raphaelauv/quadcopter-raspberry-pi/src/Motor_drone/README

#compilation
gcc  -lwiringPi -lphread -c motors.c
gcc  -lwiringPi -lphread -o test motors.o test.c
