raphaelauv/quadcopter-raspberry-pi/Documentation/Documentation Drone Harware/Description des composant.odt

Description et utilisation des composants

Micro-moteurs :

Les micro-moteurs vont fournir la puissance nécessaire au drone pour décoller, en variant la vitesse de rotation de chaque moteurs il est possible de faire tanguer/tourner le drone autours d'un axe précis afin de contrôler sa trajectoire.

Avantage et inconvenant des moteurs à courant continue.

- Variation de vitesse, couple et sens de rotation simple a gérer

- Frottement des balais (perte de rendement, perte sous forme de chaleur,

usure a grande vitesse dut au frottement et au arcs électrique qui détériore

le commutateur)

Le problème causé par les balais est régler grâce au moteur sans balais (ou brushless en anglais) qui ne contient aucun balais tout en gardant les avantages des moteurs a courant continue.

A puissance égale ils ont un meilleur rendement et sont moins chère.

Comment choisir son moteur.

- Les kv :

Les kv sont le rapport tours/min par votl. Un trop grand kv rend la maniabilité difficile car des accélérations/décélérations trop importante au moindre changement de voltage.

- Les T :

Les T sont indique le couple. Plus le T est grand, plus le couple sera important.

Les kv et le couple sont fortement lié et inversement proportionnel.

- Les Watts :

Les Watts indique la consommation maximale du moteur.

- La poussé (Thrust) :

Pour pouvoir décoller facilement il faut que la poussé total des moteurs

soit le double de la charge total du drone (donc chaque moteur doit avoir une

poussé qui soit la moitié du poids du drone)

Variateur de vitesse :

Le variateur de vitesse contrôle la tension envoyer au moteurs afin de faire varié la vitesse de celui-ci. Il doit aussi laisser passer l’ampérage dont le moteur a besoin.

Il faut donc prévoir une marge d'ampérage pour ne pas que l'ESC (electronic speed control) ne chauffe lorsque le moteur tourne a plein régime.

Il se branche directement sur la batterie. Il possède une sortie triphasé, que l'on relie au moteur. En fonction du branchement des phases nous pouvons choisir le sens de rotation du moteur.

L'ESC possède aussi ce que l'on appel un BEC output, il sert a alimenter d'autres composants comme le récepteur radio ou le contrôleur. Il permet aussi de recevoir les

paramètres que lui envoie le contrôleur.

Capteurs :

L’accéléromètre

l'accéléromètre se sert du principe de l'inertie. Prenons un support a plat sur le quel on fixe une masse a l'aide d'un ressort (la masse et a la vertical par rapport au support)

Si le support subit une accélération verticale, vers le haut, l'inertie de la masse fera que celle-ci aura tendance a vouloir rester a sa position initial (dans l'espace) et exercera donc une force de compression sur le ressort (un peu comme quand l’ascenseur commence a monter et qu'on se sent un peu lourd).

Cette effort sur le ressort et mesuré par l'accéléromètre.

Il sert donc à mesurer une accélération linéaire sur un axe. On parle d’accéléromètre même lorsqu'il s’agit de 3 accéléromètre qui calcule les accélérations sur 3 axes orthogonaux.

Le gyroscope

Un gyroscope et un solide de révolution animé d'une grande vitesse de rotation, il a pour propriété fondamentale de s'opposer à toute force qui tendrait à modifier l'orientation de son axe de rotation (il conserve son axe de rotation dans l'espace absolue).

Le gyroscope est donc un capteur de position angulaire par rapport a un référentiel inertiel (ou galiléen). Il mesure donc l'angle du drone sur les 3 axes (les deux axes du plan qui sont appelé axes de roulis (barrel roll) et de tangage (looping) et l'axe vertical appelé axe de lacet)

Enfin les capteurs de pression, humidité et chaleur donne des information complémentaire, comme la hauteur (différence de pression) et les capteurs de chaleur et d'humidité peuvent repérer la présence proche d'un objet « vivant » (ou chaud et/ou humide)

La batterie (ou accumulateur)

Les batterie utilisé sont des Batterie LiPo, elle possède l'avantage de pouvoir fournir une tension « constante » lors de sont utilisation, ce qui n'etait pas le cas avec les les autre batterie qui perdait en puissance au cours de leur utilisation.

L’inconvénient et que si elle passe en dessous d'un seuil de tension, c'est tout simplement poubelle. Il ne faut pas passer en dessous des 2,8 ~ 3 V par élément, la tension de destruction étant à 2,5V

Il faut aussi faire attention a l'équilibre de tension entre chaque élément.

Si il y a un déséquilibre certaine cellule seront plus sollicité que d'autre ce qui détériore la batterie, idem à la charge.

Il faut donc penser a prendre un chargeur équilibreur et ce à chaque charge.

Il faut aussi penser a laisser les accumulateur se refroidir / se reposer entre chaque charge / décharge (entre 1/4h et 1h)

Sources

http://sparrowhawk-xxt.e-monsite.com/pages/technique/choisir-son-moteur-brushless-et-le-variateur.html

https://fr.wikipedia.org/wiki/Machine_%C3%A0_courant_continu

https://fr.wikipedia.org/wiki/Moteur_sans_balais

https://en.wikipedia.org/wiki/Battery_eliminator_circuit

https://fr.wikipedia.org/wiki/Acc%C3%A9l%C3%A9rom%C3%A8tre#Approche_intuitive (https://fr.wikipedia.org/wiki/Accéléromètre#Approche_intuitive)

https://fr.wikipedia.org/wiki/Gyroscope

http://blog.patrickmodelisme.com/post/qu-est-ce-qu-une-batterie-lipo
