raphaelauv/quadcopter-raspberry-pi/Documentation/ Documentation Code Softawre/Diagramme.jpeg

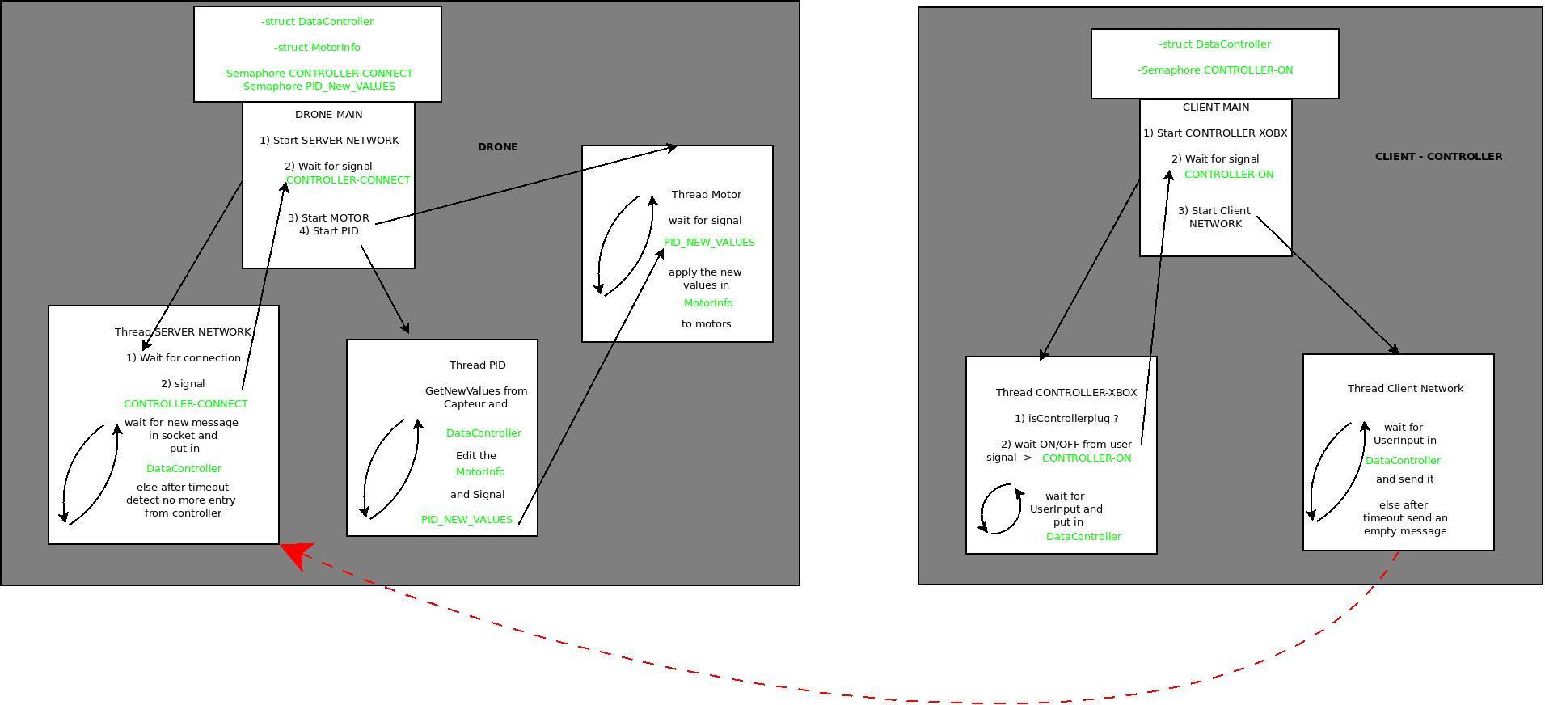
Documentation/ Documentation Code Softawre/Diagramme.jpeg
