raphaelauv/quadcopter-raspberry-pi/Documentation/ Documentation Code Softawre/Diagramme_client.png

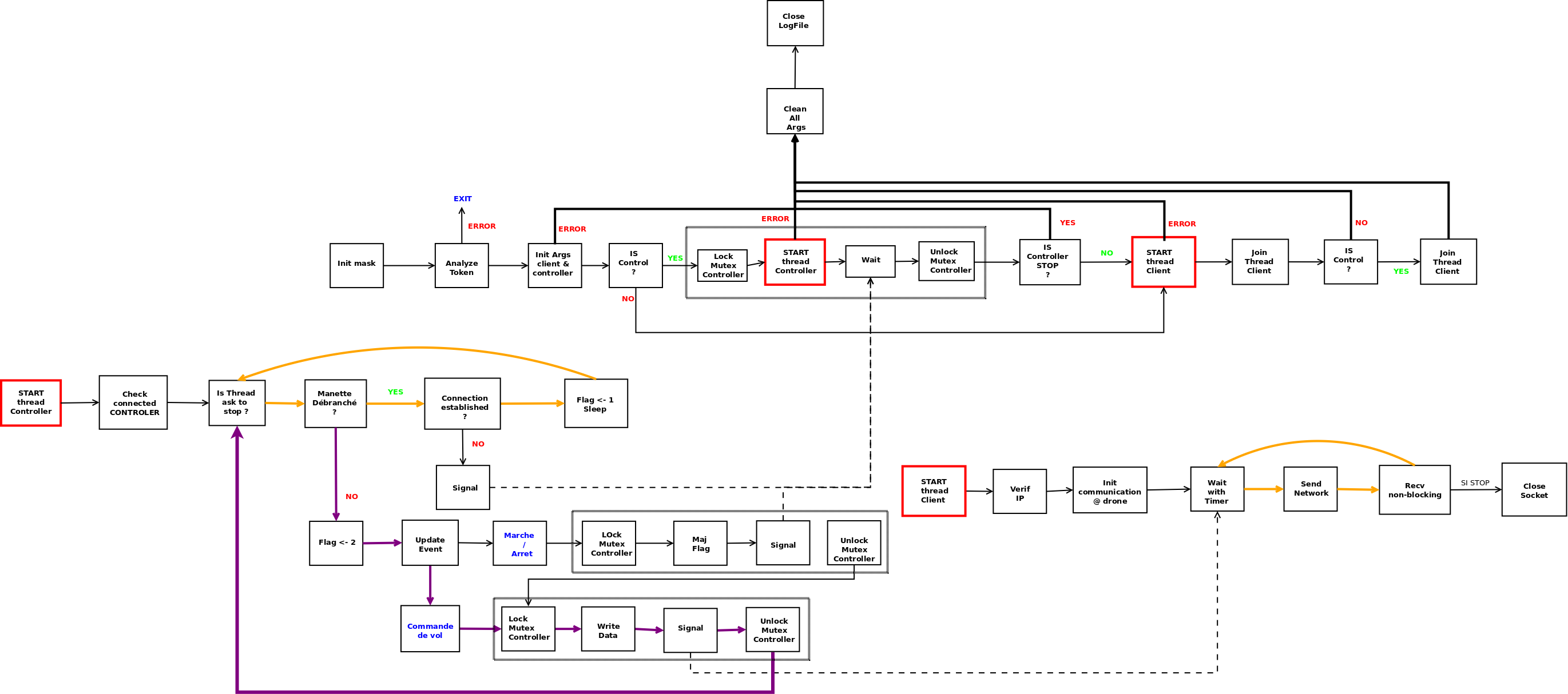
Documentation/ Documentation Code Softawre/Diagramme_client.png
