raphaelauv/quadcopter-raspberry-pi/Documentation/ Documentation Code Softawre/Diagramme_drone.png

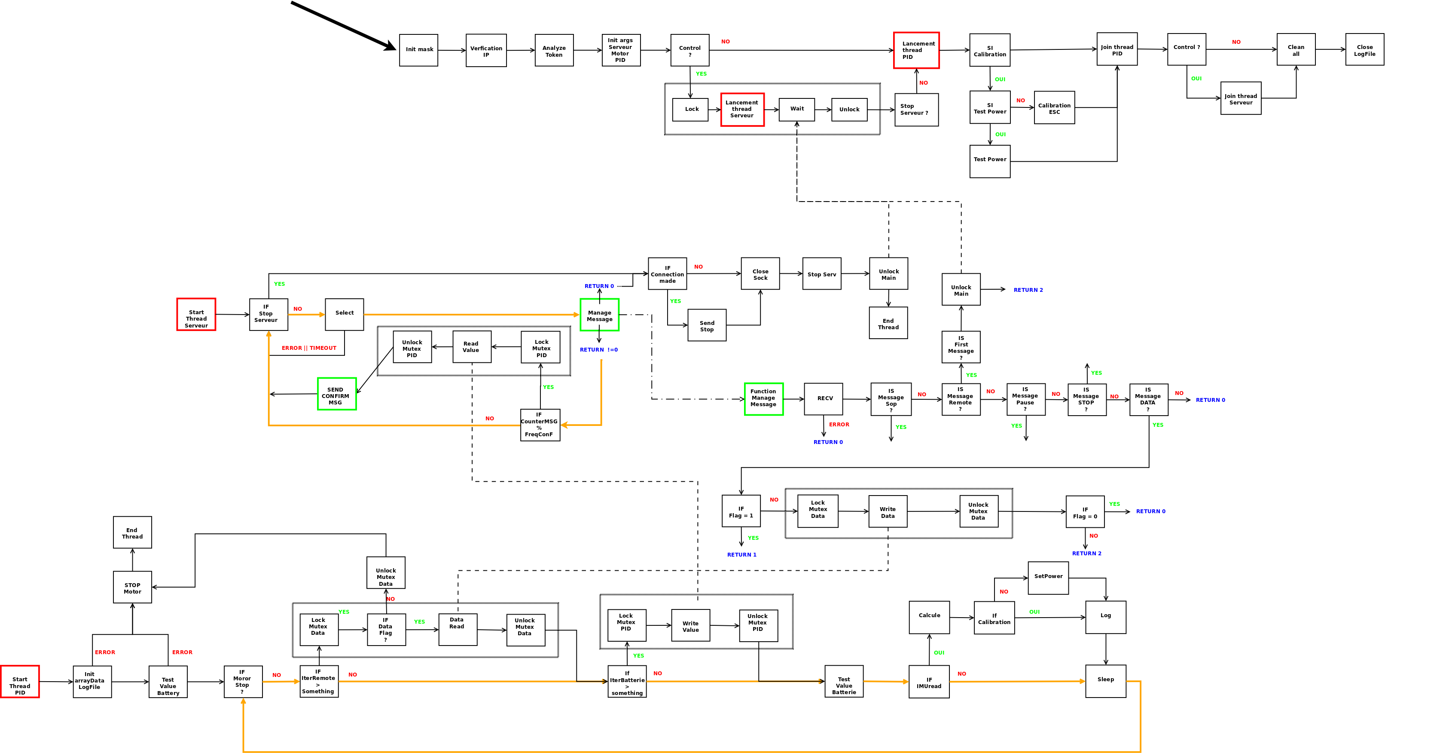
Documentation/ Documentation Code Softawre/Diagramme_drone.png
