raphaelauv/quadcopter-raspberry-pi/TODO.txt

#############################TODO#############################
-Fair un schema des branchement du drone(Andres)
-Monter le drone(ASAP).
-makefile avec library dynamique(Andres)
-Mode log avec graphe pour PID.
-mode log pour les motor(valeurs de la puissance des 4 motors).
-Gérer les signaux.(Adrian)
-Meme Test d’equilibrage  mais avec la manette.(Andres) 
-Test controlVol complet deja (ecrit) (Andres)
-Voir qu’elle materiel on aura besoin de plus? (Tous le monde).
-Filtre de Kalman (Barometre + accel) (Andres + ?)
-Test de securité.
-Comprendre le code de Raph. (Adrian + Andres).
