raphaelauv/quadcopter-raspberry-pi/plot/testPower droit dans la main.pdf

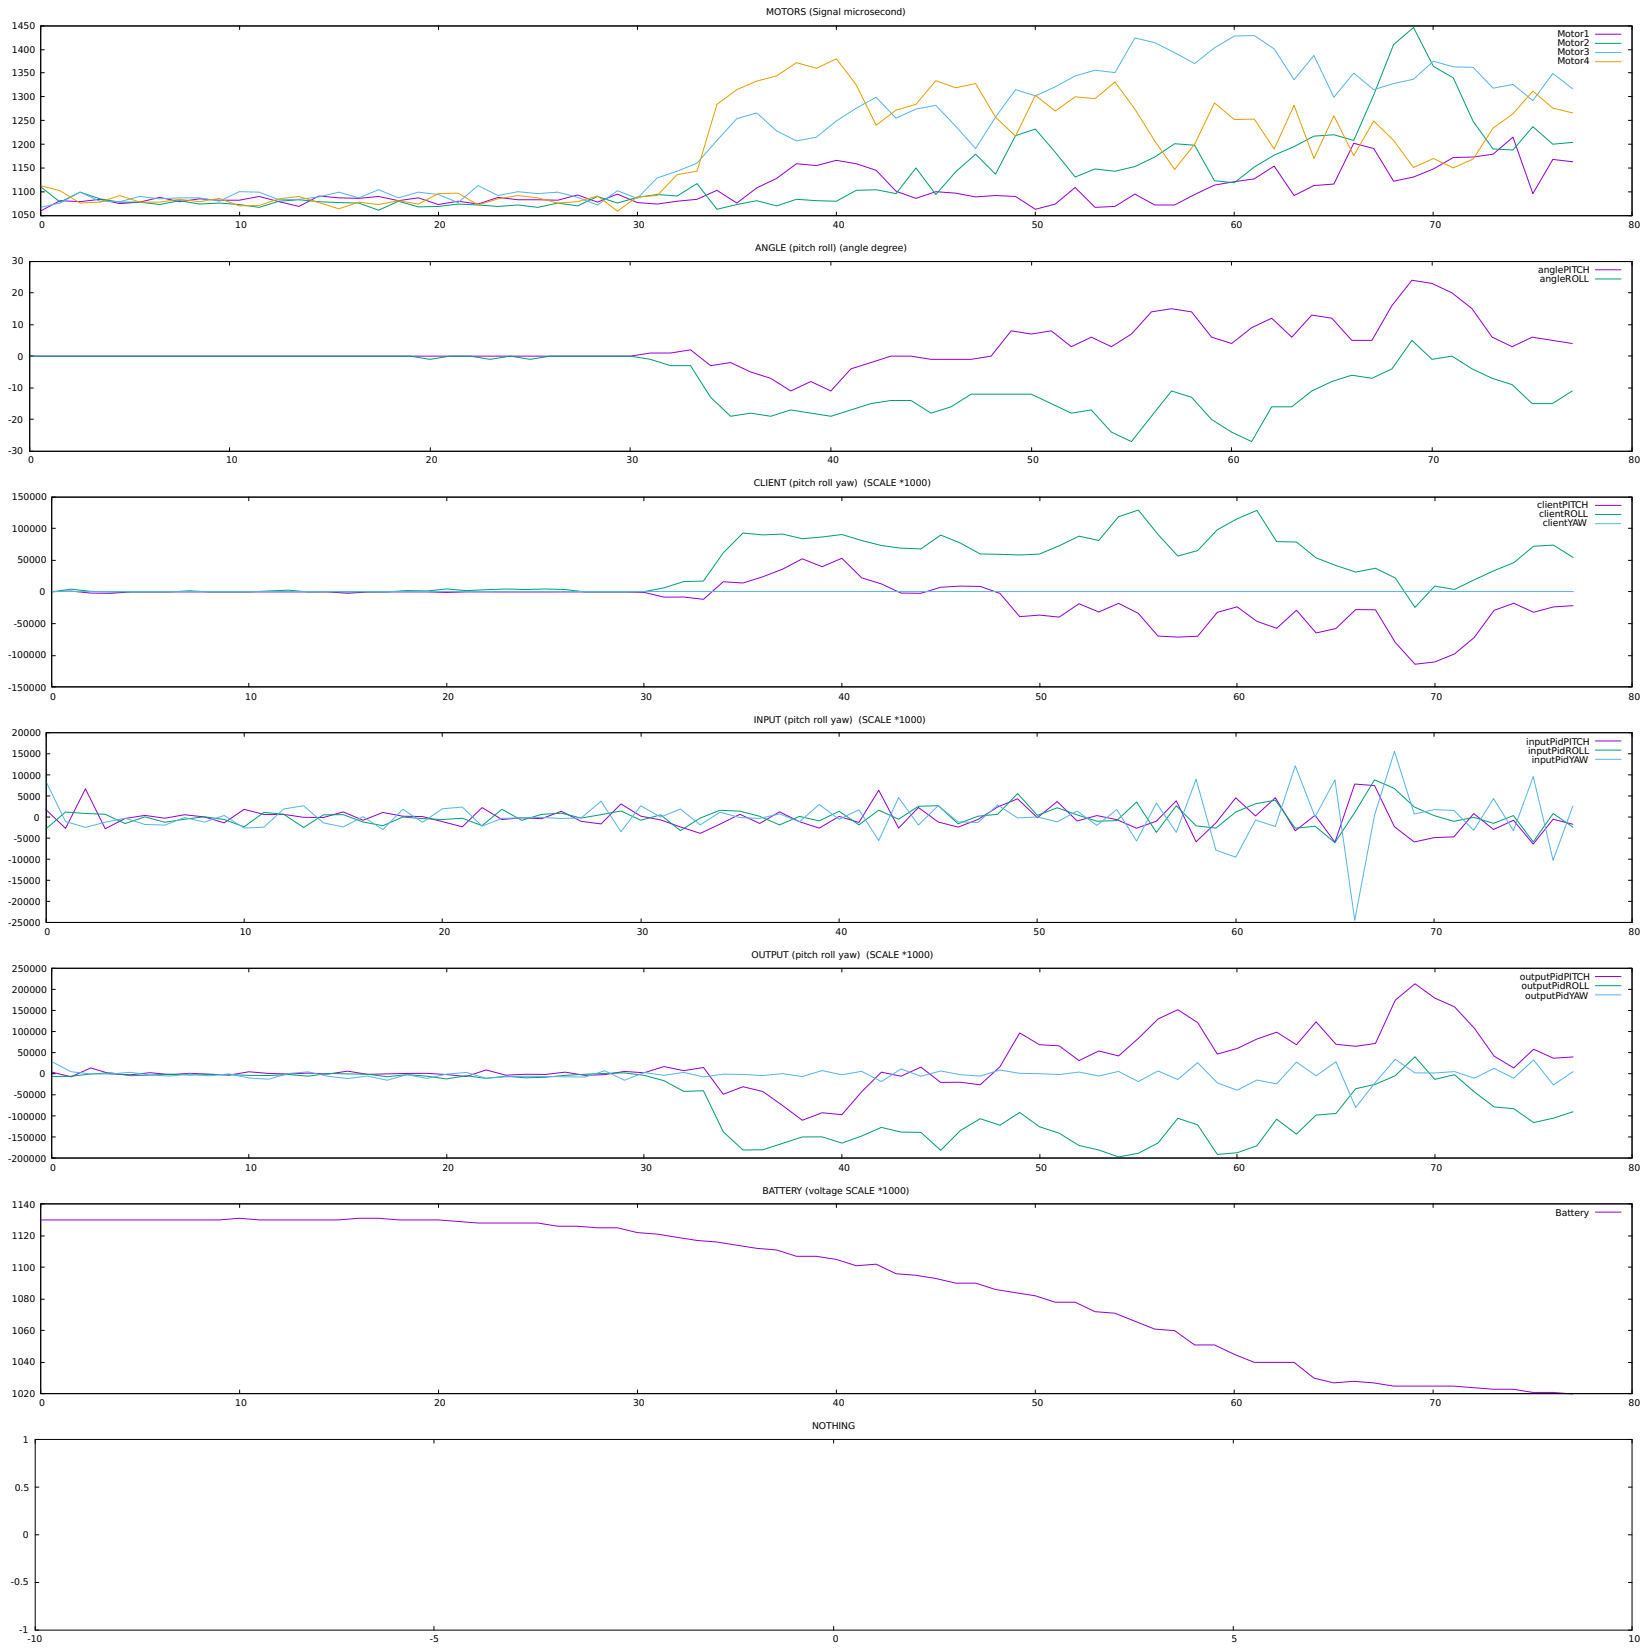
[picture p6: page 1]
Sig; al mic; pit; oll); gle; PITC; LIE; oll y; clie; YAW; 0 INPUT (pitch roll yaw) (SCALE *1000); inputPidPITCH inputPidROLL inputPidYAW; Pid; ATT; olt; HIN
