raphaelauv/quadcopter-raspberry-pi/Documentation/Documentation Drone Harware/Cablage_Drone.pdf

## Raspberry Pi 2

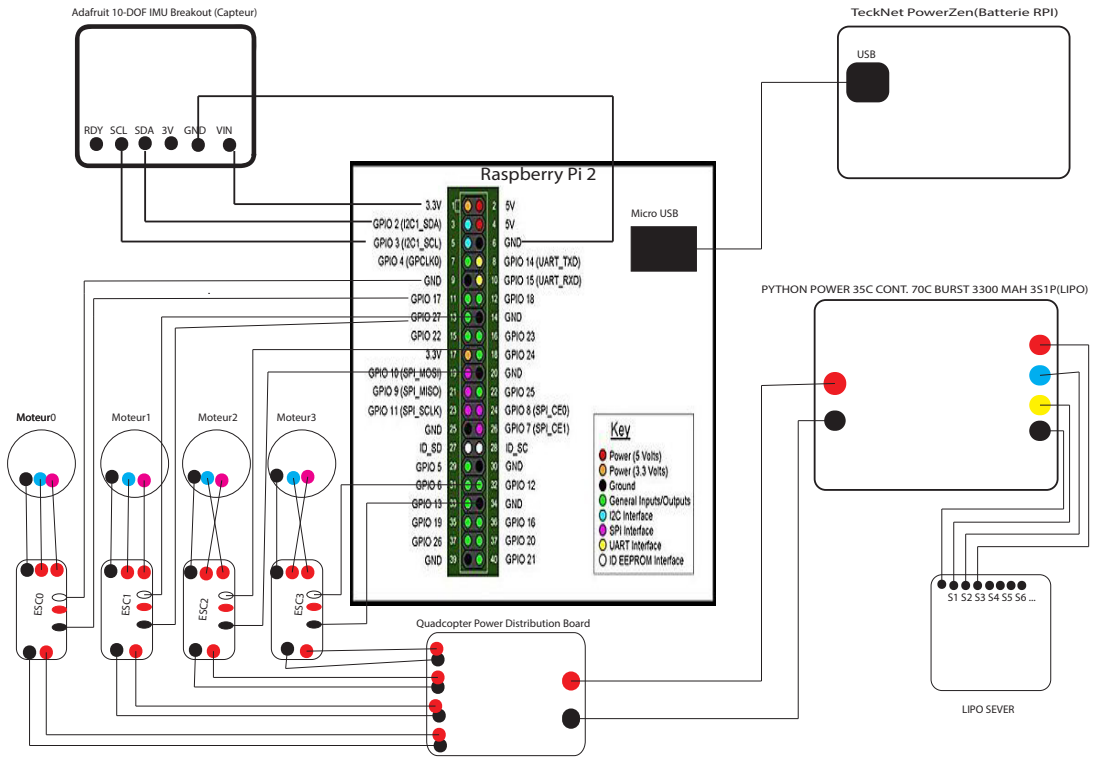
[picture p7: page 1]
Micro USB; USB; LIPO SEVER; ESC0; ESC1; ESC2; ESC3; Moteur0 Moteur; Moteur1; Moteur2; Moteur3

Adafruit 10-DOF IMU Breakout (Capteur)

TeckNet PowerZen(Batterie RPI)

RDY SCL SDA 3V GND VIN

PYTHON POWER 35C CONT. 70C BURST 3300 MAH 3S1P(LIPO)

Quadcopter Power Distribution Board
