raphaelauv/quadcopter-raspberry-pi/src/PID.cpp

#include "PID.hpp"


int init_args_PID(args_PID ** argPID){

#ifdef __arm__
	RTIMU *imu = NULL;
#endif

    *argPID =(args_PID *) malloc(sizeof(args_PID));
    if (*argPID == NULL) {
        logString("MALLOC FAIL : init_args_PID");
        return -1;
    }
    
    
#ifdef __arm__
    imu = sensorInit();
    if(imu==NULL){
        logString("ERROR NEW FAIL RTIMU ->imu");
        goto cleanFail;
    }else{
        logString("CAPTEUR INIT SUCCES");
        (*argPID)->imu=imu;
    }
#endif
    
    if(initHardwareADC(DEFAULT_CHANNEL_ADCNUM)){
    	logString("initHardwareADC FAIL");
    	goto cleanFail;
    }

    return 0;

cleanFail:
	clean_args_PID(*argPID);
	*argPID=NULL;
	return -1;
}

void clean_args_PID(args_PID * arg) {
    if (arg != NULL) {
		#ifdef __arm__
        if( arg->imu !=NULL){
            delete(arg->imu);
            arg->imu=NULL;
        }
		#endif
        free(arg);
    }
}




void * thread_PID(void * args);

/**
 * return 0 if Succes
 */
int start_thread_PID(pthread_t * threadPID,void *threadPID_stack_buf,args_PID * argPID){
    
    pthread_attr_t attributs;
    if(init_Attr_Pthread(&attributs,CPU_PRIORITY_PID,CPU_CORE_PID,threadPID_stack_buf)){
        logString("THREAD MAIN : ERROR pthread_attributs PID");
        return -1;
    }
    
    int result=pthread_create(threadPID, &attributs, thread_PID, argPID);
    if (result) {
        logString("THREAD MAIN : ERROR pthread_create PID");
        perror("pthread_create");
    }
    
    pthread_attr_destroy(&attributs);
    
    return result;
}



int absValue(int val){
    if(val<0){
        val*=-1;
    }
    val*=10;
    val+=1000;
    if(val<1000){
        val=1000;
    }
    else if(val>2000){
        val=2000;
    }
    return val;
}

float batteryValue=0;

int applyFiltreBatteryValue(){

	int batteryVoltage=hardwareReadADC(DEFAULT_CHANNEL_ADCNUM);
	if(batteryVoltage==-1){
		return -1;
	}

	//TODO PUT VALUES IN MACRO
	batteryValue=batteryValue* 0.92 + (batteryVoltage+60)* 0.09509;


	//batteryValue*=CONVERTION_TO_VOLT;

	return 0;

}

void * thread_PID(void * args){
	int continuThread=1;


	logString("THREAD PID : INITIALISATION");

    args_PID  * controle_vol =(args_PID  *)args;
    DataController * data = controle_vol->dataController;
    PMutex * mutexDataControler =controle_vol->dataController->pmutex;
    PID_INFO * pidInfo =controle_vol->pidInfo;

	#ifdef __arm__
    RTIMU *imu =(RTIMU *)controle_vol->imu;
	#endif

    long local_period=(1.0/FREQUENCY_PID) *SEC_TO_NSEC;

    
    int nbSENSOR_read_fail_InARow = 0;


    //Consigne client
    float client_gaz = MOTOR_MIN_ROTATE_TIME;
    float lastClient_gaz = client_gaz;
    char connectionlost = 0;

    int intervalReductionGAZ = 5;
    int nbConnectionLost_InARow = 0;

    int nbConnectionLost_GAZMIN = 0;

    float client_pitch = 0;
    float client_roll=0;
    float client_yaw=0;
    
    //input PID
    float input_pid_pitch;
    float input_pid_roll;
    float input_pid_yaw;
    //PID
    float output_pid_pitch = 0;
    float output_pid_roll = 0;
    float output_pid_yaw = 0;
    //erreur des PID
    float pid_erreur_tmp_pitch = 0;
    float pid_erreur_tmp_roll = 0;
    float pid_erreur_tmp_yaw = 0;
    //erreur accu
    float pid_accu_erreur_pitch = 0;
    float pid_accu_erreur_roll = 0;
    float pid_accu_erreur_yaw = 0;
    //last erreur
    float pid_last_pitch = 0;
    float pid_last_roll = 0;
    float pid_last_yaw = 0;
    
    // puissance des 4 moteur. (en microseconde)
    int puissance_motor0 = MOTOR_LOW_TIME;
    int puissance_motor1 = MOTOR_LOW_TIME;
    int puissance_motor2 = MOTOR_LOW_TIME;
    int puissance_motor3 = MOTOR_LOW_TIME;
    int powerTab[NUMBER_OF_MOTORS];
    int powerController[4];
    int powerMinRotate[NUMBER_OF_MOTORS];

    for(int i=0;i<NUMBER_OF_MOTORS;i++){
    	powerController[i]=0;
    	powerTab[i]=MOTOR_LOW_TIME;
    	powerMinRotate[i]=MOTOR_MIN_ROTATE_TIME;
    }

    
    RTIMU_DATA imuData;
    float gyro_cal[3]={0,0,0};

    
    int nb_values_log=NUMBER_OF_MOTORS+2+(3*3)+1;//( motors -> 4 ) + 2 angles ( (pitch roll yaw) * 3 ) + BatteryLevel
	int logTab[nb_values_log];
	int log_angle_pitch;
	int log_angle_roll;

	char arrayLog[SIZE_MAX_LOG];
	char arrayDATA[SIZE_MAX_LOG];

    struct timespec t0, t1 ,tim;
    int modeCalibration=isCalibration();

    int iterRemote=0;
    int iterBattery=0;
    int iterPrintPower=0;
    int iterBatteryPrint=0;
    int readSensorSucces=0;

	float gyro_x;
	float gyro_y;
	float gyro_z;

    /********VIBRATION******/
    float acc_total_vector[VIBRATION_Moving_average];
    for(int i=0;i<VIBRATION_Moving_average;i++){
    	acc_total_vector[i]=0;
    }
    float acc_av_vector;
    float vibration_total_result;
    float acc_x;
    float acc_y;
    float acc_z;

    int iterAccelPrint=0;
    int iterVibration;
    int testvibration=isTestVibration();
    float lastVibration;


    /*******SECURITY TIMER****/
    int iterSecurityTimer=0;
    int counterSecuTimer=PID_TIMER_TIME_SECURITE_SECONDE;
    int lastCounterSecuTimer=counterSecuTimer;
    int nanoSleepTimeIntervalOfSecurityTimer = NSEC_TO_SEC / PID_TIMER_VERIF_FREQUENCY;
    char tmpFlagRemoteMSG=0;
    int nbRotateSecuTimer=0;


    /*******DATA LOG FILE INIT****/
    char * strNameColumnDATA ="Motor1 Motor2 Motor3 Motor4 anglePITCH angleROLL clientPITCH clientROLL clientYAW inputPidPITCH inputPidROLL inputPidYAW outputPidPITCH outputPidROLL outputPidYAW Battery";
    if(setDataFrequence(50,nb_values_log)){
    	logString("THREAD PID : ERROR setDataFrequence");
    	goto endPid;
    }

    if (setDataStringTitle(strNameColumnDATA)) {
    	logString("THREAD PID : ERROR setDataStringTitle");
    	goto endPid;
	}





    /*********************************************************/
    /*				CALIBRATION ACCEL						*/
    /*
    int i;
	#ifdef __arm__
		for (i=0; i<2000; i++) {
			if(imu->IMURead()){
				imuData = imu->getIMUData();
				gyro_cal[0]+=imuData.gyro.x();
				gyro_cal[1]+=imuData.gyro.y();
				gyro_cal[2]+=imuData.gyro.z();
			}
			else{
				printf("trop rapide");
			}
			//usleep(2000);
			nanoSleepSecure(2000 *NSEC_TO_USEC_MULTIPLE);
		}
		gyro_cal[0]/=2000;
		gyro_cal[1]/=2000;
		gyro_cal[2]/=2000;
		printf("Calibration fini\n");
	#endif
    */



    /*********************************************************/
    /*				BATTERY INIT VALUE	+ TEST MOTO			*/

    for(int i=0;i<FREQUENCY_PID;i++){
    	if(applyFiltreBatteryValue()){
    		logString("THREAD PID : ERROR BATTERY VALUE");
    		goto endPid;
    	}

    	if(set_power(controle_vol->motorsAll, powerTab)){
    		goto endPid;
    	}
    }

    /*********************************************************/



    /*********************************************************/
    /*				START PID SECURITY TIMER				*/

    if(isCalibration()){
    	iterSecurityTimer=PID_TIMER_TIME_SECURITE_SECONDE * PID_TIMER_VERIF_FREQUENCY;
    	//to skip security timer
    }else{
    	logString("THREAD PID : SECURITY TIMER START");
    }


    while(iterSecurityTimer<PID_TIMER_TIME_SECURITE_SECONDE * PID_TIMER_VERIF_FREQUENCY){

    	iterSecurityTimer++;
    	pthread_mutex_lock(&(mutexDataControler->mutex));
    	tmpFlagRemoteMSG=data->flag;
    	pthread_mutex_unlock(&(mutexDataControler->mutex));
		if (tmpFlagRemoteMSG == 0) {
			continuThread=0;
			break;
		}
		if (is_Motor_Stop(controle_vol->motorsAll)) {
			continuThread=0;
			break;
		}

		if(iterSecurityTimer%PID_TIMER_VERIF_FREQUENCY==0){
			counterSecuTimer--;
			sprintf(arrayLog,"THREAD PID : SECURITY TIMER  %d",counterSecuTimer);
			logString(arrayLog);
		}

		if(lastCounterSecuTimer!=counterSecuTimer){
			lastCounterSecuTimer=counterSecuTimer;
			nbRotateSecuTimer=5;

		}

    	else{
    		clockNanoSleepSecure(nanoSleepTimeIntervalOfSecurityTimer);
		}

		//for very lite rotation of propeller during the timer security
		if(nbRotateSecuTimer>0){
			//set_power(controle_vol->motorsAll,powerMinRotate);
			nbRotateSecuTimer--;
		}else{
			//set_power(controle_vol->motorsAll,powerTab);
		}
    }
    /****************END SECURITY TIMER*************************/


    if(continuThread){
    	logString("THREAD PID : START");
    }

    while (continuThread) {

    	clock_gettime(CLOCK_MONOTONIC, &t0);//TODO

        if(is_Motor_Stop(controle_vol->motorsAll)){
        	break;
        }
        
        /*********************************************************/
        /*					CODE FOR GET REMOTE					*/
        iterRemote++;
        if(iterRemote>FREQUENCY_PID/FREQUENCY_CONTROLLER){
        	iterRemote=0;
            pthread_mutex_lock(&(mutexDataControler->mutex));
            if (data->flag== 0) {
                pthread_mutex_unlock(&(mutexDataControler->mutex));
                break;
                //TODO take a different decision when the flag is at 0 from the remote
            }else{
            	//mutexDataControler->var = 0;
				powerController[0] = data->axe_Rotation;
				powerController[1] = data->axe_UpDown;
				powerController[2] = data->axe_LeftRight;
				powerController[3] =(-1) * data->axe_FrontBack;
				pthread_mutex_unlock(&(mutexDataControler->mutex));


				/*
				Each motor id directly control by the pads of joystick
				powerTab[0] =absValue(powerController[0]);
				powerTab[1] =absValue(powerController[1]);
				powerTab[2] =absValue(powerController[2]);
				powerTab[3] =absValue(powerController[3]);
				printf("VALUES %d %d %d %d\n", powerTab[0],powerTab[1],powerTab[2],powerTab[3]);
				set_power(controle_vol->motorsAll,powerTab);
				*/

            }
            
        }

        /*********************************************************/
		/*					CODE BATTERY				*/
		iterBattery++;
		iterBatteryPrint++;
		if (iterBatteryPrint > (FREQUENCY_PID * 2)) {

			float voltageValue=batteryValue * 0.01;

			sprintf(arrayLog,"THREAD PID : Battery Value : %f",voltageValue);
			logString(arrayLog);
			iterBatteryPrint = 0;
		}


		if(applyFiltreBatteryValue()){
			logString("THREAD PID : ERROR BATTERY VALUE");
			//TODO
		}

        /************************END BATTERIE****************************/


		/************************POWER CLIENT****************************/
		pthread_mutex_lock(&(pidInfo->pmutex->mutex));
		connectionlost = pidInfo->connectionLost;
		pthread_mutex_unlock(&(pidInfo->pmutex->mutex));

		if (connectionlost) {

			nbConnectionLost_InARow++;
			if (nbConnectionLost_InARow % intervalReductionGAZ == 0) {
				client_gaz = lastClient_gaz--;
			}

			if (client_gaz <= 1300) {

				nbConnectionLost_GAZMIN++;

				if (nbConnectionLost_GAZMIN > FREQUENCY_PID * 11) {
					logString("THREAD PID : CONNECTION FAIL PID GO END");
					break;
				}else if (nbConnectionLost_GAZMIN > FREQUENCY_PID * 9) {
					client_gaz = 1050;
				}
				else if (nbConnectionLost_GAZMIN > FREQUENCY_PID * 7) {
					client_gaz = 1150;
				}
				else if (nbConnectionLost_GAZMIN > FREQUENCY_PID * 5) {
					client_gaz = 1250;
				}else{
					client_gaz = 1300;
				}

			}

		} else {
			nbConnectionLost_InARow = 0;
			if (powerController[1] >= 0) {

				//TODO add filter to limit burst du to reconnection

				client_gaz = (powerController[1]
						* (MAX_POURCENTAGE_POWER_USER / 10)) + MOTOR_LOW_TIME;
			}
		}

		if (client_gaz < MOTOR_MIN_ROTATE_TIME) {
			client_gaz = MOTOR_MIN_ROTATE_TIME;
		}

		lastClient_gaz = client_gaz;

		/***********************END POWER CLIENT**************************/
        
		#ifdef __arm__
        if(imu->IMURead()){
        	readSensorSucces=1;
        	nbSENSOR_read_fail_InARow=0;
        }else{
        	logString("THREAD PID : SENSOR FAIL READ");
        	readSensorSucces=0;
        	nbSENSOR_read_fail_InARow++;
        	if(nbSENSOR_read_fail_InARow>10){
        		//TODO
        	}
        }
		#endif

        if(readSensorSucces){
			#ifdef __arm__
            imuData = imu->getIMUData();
			#endif

            /*************************VIBRATION**********************/
            if(testvibration){

                acc_x=imuData.accel.x();
                acc_y=imuData.accel.y();
                acc_z=imuData.accel.z();
    			acc_total_vector[0] = sqrtf((acc_x * acc_x) + (acc_y * acc_y) + (acc_z * acc_z));

    			acc_av_vector = acc_total_vector[0];

    			for (int start = 16; start > 0; start--) {
    				acc_total_vector[start] = acc_total_vector[start - 1];
    				acc_av_vector += acc_total_vector[start];
    			}

    			acc_av_vector /= 17;

    			if (iterVibration < VIBRATION_Moving_average) {
    				iterVibration++;
    				vibration_total_result += fabsf(acc_total_vector[0] - acc_av_vector);
    			} else {
    				iterVibration = 0;
    				lastVibration = vibration_total_result/VIBRATION_Moving_average;
    				vibration_total_result = 0;
    			}
    			
    			iterAccelPrint++;
    			if (iterAccelPrint > (FREQUENCY_PID / 2)) {
    				iterAccelPrint = 0;
    				printf("ACCEL : X : %f  Y : %f  Z : %f | VECTEUR : %f | VIBRATION : %f \n", acc_x, acc_y, acc_z,acc_total_vector[0],lastVibration);
    			}
            }
            /**********************END VIBRATION**********************/


            /*************************PID*****************************/
            
            gyro_x=imuData.gyro.x();
            gyro_y=imuData.gyro.y();
            gyro_z=imuData.gyro.z();

			//printf("GYRO : X : %f  Y : %f  Z : %f \n",gyro_x, gyro_y, gyro_z);

            input_pid_pitch=(input_pid_pitch*0.7) + ((gyro_y-gyro_cal[0])*(180/M_PI)*0.3);
            input_pid_roll=(input_pid_roll*0.7) + ((gyro_x-gyro_cal[1])*(180/M_PI)*0.3);
            input_pid_yaw=(input_pid_yaw*0.7) + ((gyro_z-gyro_cal[2])*(180/M_PI)*0.3);
            
            //*power client

            client_pitch=powerController[3] * PID_ANGLE_PRECISION_MULTIPLE;
            client_roll=powerController[2] * PID_ANGLE_PRECISION_MULTIPLE;
            client_yaw=powerController[0] * PID_ANGLE_PRECISION_MULTIPLE;
            

            //TODO , correct the vibration first , before use the ANGLES
            /*
            log_angle_pitch=imuData.fusionPose.y() * RTMATH_RAD_TO_DEGREE;
            client_pitch-= log_angle_pitch * PID_ANGLE_MULTIPLE;
            */
            client_pitch/=3;

            /*
            log_angle_roll = imuData.fusionPose.x() * RTMATH_RAD_TO_DEGREE;
            client_roll-= log_angle_roll * PID_ANGLE_MULTIPLE;
            */
            client_roll/=3;
            
            client_yaw/=3;
            
            

            //calcule pitch PID
            pid_erreur_tmp_pitch=input_pid_pitch-client_pitch;
            pid_accu_erreur_pitch+=PID_GAIN_I_PITCH*pid_erreur_tmp_pitch;
            if (pid_accu_erreur_pitch>PID_MAX_PITCH) {
                pid_accu_erreur_pitch=PID_MAX_PITCH;
            }
            else if (pid_accu_erreur_pitch < -PID_MAX_PITCH){
                pid_accu_erreur_pitch=-PID_MAX_PITCH;
            }
            
            output_pid_pitch=PID_GAIN_P_PITCH*pid_erreur_tmp_pitch+pid_accu_erreur_pitch+PID_GAIN_D_PITCH*(pid_erreur_tmp_pitch-pid_last_pitch);
            
            if (output_pid_pitch>PID_MAX_PITCH) {
                output_pid_pitch=PID_MAX_PITCH;
            }
            else if (output_pid_pitch < -PID_MAX_PITCH){
                output_pid_pitch=-PID_MAX_PITCH;
            }
            pid_last_pitch=pid_erreur_tmp_pitch;
            //END PID PITCH
            
            //calcule roll PID
            pid_erreur_tmp_roll=input_pid_roll-client_roll;
            pid_accu_erreur_roll+=PID_GAIN_I_ROLL*pid_erreur_tmp_roll;
            if (pid_accu_erreur_roll>PID_MAX_ROLL) {
                pid_accu_erreur_roll=PID_MAX_ROLL;
            }
            else if (pid_accu_erreur_roll < -PID_MAX_ROLL){
                pid_accu_erreur_roll=-PID_MAX_ROLL;
            }
            
            output_pid_roll=PID_GAIN_P_ROLL*pid_erreur_tmp_roll+pid_accu_erreur_roll+PID_GAIN_D_ROLL*(pid_erreur_tmp_roll-pid_last_roll);

            if (output_pid_roll>PID_MAX_ROLL) {
                output_pid_roll=PID_MAX_ROLL;
            }
            else if (output_pid_roll < -PID_MAX_ROLL){
                output_pid_roll=-PID_MAX_ROLL;
            }
            
            pid_last_roll=pid_erreur_tmp_roll;
            //END PID ROLL
            
            //PID YAW
            pid_erreur_tmp_yaw=input_pid_yaw-client_yaw;
            pid_accu_erreur_yaw+=PID_GAIN_I_YAW*pid_erreur_tmp_yaw;
            
            if (pid_accu_erreur_yaw>PID_MAX_YAW) {
                pid_accu_erreur_yaw=PID_MAX_YAW;
            }
            else if (pid_accu_erreur_yaw < -PID_MAX_YAW){
                pid_accu_erreur_yaw=-PID_MAX_YAW;
            }
            
            output_pid_yaw=PID_GAIN_P_YAW*pid_erreur_tmp_yaw+pid_accu_erreur_yaw;
            
            if (output_pid_yaw>PID_MAX_YAW) {
                output_pid_yaw=PID_MAX_YAW;
            }
            else if (output_pid_yaw < -PID_MAX_YAW){
                output_pid_yaw=-PID_MAX_YAW;
            }
            
            
            
            puissance_motor0=client_gaz - output_pid_pitch + output_pid_roll - output_pid_yaw;
            puissance_motor1=client_gaz + output_pid_pitch + output_pid_roll + output_pid_yaw;
            puissance_motor2=client_gaz + output_pid_pitch - output_pid_roll - output_pid_yaw;
            puissance_motor3=client_gaz - output_pid_pitch - output_pid_roll + output_pid_yaw;

            /***********************END PID**********************/
        }


        /*******************BATTERY MOTOR CALIB**************/

		  //TODO
		 if(batteryValue<=BATTERY_HIGH_LIMIT && batteryValue>=BATTERY_LOW_LIMIT){
		/*
		 *
		 * NOT WORKING YET
			int a=10;
			int b=-20;
			puissance_motor0 +=  ((100 -   ((a*(batteryValue*0.01)) + b))  *puissance_motor0) / 100 ;
			puissance_motor1 +=  ((100 -   ((a*(batteryValue*0.01)) + b))  *puissance_motor1) / 100 ;
			puissance_motor2 +=  ((100 -   ((a*(batteryValue*0.01)) + b))  *puissance_motor2) / 100 ;
			puissance_motor3 +=  ((100 -   ((a*(batteryValue*0.01)) + b))  *puissance_motor3) / 100 ;
			*/

			/* WORKING , BUT NOT FULLY TEST
			puissance_motor0 += (1240 - batteryValue) /3500 * puissance_motor0 ;
			puissance_motor1 += (1240 - batteryValue) /3500 * puissance_motor1 ;
			puissance_motor2 += (1240 - batteryValue) /3500 * puissance_motor2 ;
			puissance_motor3 += (1240 - batteryValue) /3500 * puissance_motor3 ;

			*/

		  }
		  /*****************END BATTERY MOTOR CALIB*************/


		  /*******************SECURITY VALUES MOTORS**************/

		  //NEVER STOP ROTATION OF PROPELLERS
		  if(puissance_motor0<MOTOR_MIN_ROTATE_TIME) puissance_motor0=MOTOR_MIN_ROTATE_TIME;
		  if(puissance_motor1<MOTOR_MIN_ROTATE_TIME) puissance_motor1=MOTOR_MIN_ROTATE_TIME;
		  if(puissance_motor2<MOTOR_MIN_ROTATE_TIME) puissance_motor2=MOTOR_MIN_ROTATE_TIME;
		  if(puissance_motor3<MOTOR_MIN_ROTATE_TIME) puissance_motor3=MOTOR_MIN_ROTATE_TIME;

		  //MAXIMUM TO ASK IS LIMIT OF MOTORS
		  if(puissance_motor0>MOTOR_HIGH_TIME) puissance_motor0=MOTOR_HIGH_TIME;
		  if(puissance_motor1>MOTOR_HIGH_TIME) puissance_motor1=MOTOR_HIGH_TIME;
		  if(puissance_motor2>MOTOR_HIGH_TIME) puissance_motor2=MOTOR_HIGH_TIME;
		  if(puissance_motor3>MOTOR_HIGH_TIME) puissance_motor3=MOTOR_HIGH_TIME;

		  /****************END SECURITY VALUES MOTORS************/
	/*
		  iterPrintPower++;
		  if (iterPrintPower > (FREQUENCY_PID * 5)) {
			iterPrintPower=0;
			printf("PUISSANCE : %d %d %d %d \n", puissance_motor0,puissance_motor1,puissance_motor2,puissance_motor3);
		}

	*/

		powerTab[0] = puissance_motor0;
		powerTab[1] = puissance_motor1;
		powerTab[2] = puissance_motor2;
		powerTab[3] = puissance_motor3;

		if (modeCalibration) {
			//nothing to apply because we are in a calibrate mode execution
		} else {
			set_power(controle_vol->motorsAll, powerTab);
			//TODO test return value of set_power and take a decision !!
		}

		/*************************END PID****************************/


		/****************************LOG*****************************/
		logTab[0]=powerTab[0];
		logTab[1]=powerTab[1];
		logTab[2]=powerTab[2];
		logTab[3]=powerTab[3];

		logTab[4]=(int)log_angle_pitch;
		logTab[5]=(int)log_angle_roll;

		logTab[6]=(int) (client_pitch * LOG_FLOAT_MULTIPLIER);
		logTab[7]=(int) (client_roll * LOG_FLOAT_MULTIPLIER);
		logTab[8]=(int) (client_yaw  * LOG_FLOAT_MULTIPLIER);

		logTab[9]=(int) (input_pid_pitch  * LOG_FLOAT_MULTIPLIER);
		logTab[10]=(int) (input_pid_roll * LOG_FLOAT_MULTIPLIER);
		logTab[11]=(int) (input_pid_yaw * LOG_FLOAT_MULTIPLIER);

		logTab[12]=(int) (output_pid_pitch * LOG_FLOAT_MULTIPLIER);
		logTab[13]=(int) (output_pid_roll * LOG_FLOAT_MULTIPLIER);
		logTab[14]=(int) (output_pid_yaw * LOG_FLOAT_MULTIPLIER);

		logTab[15]=(int) batteryValue;
		logDataFreq(logTab,nb_values_log,arrayDATA);

		pthread_mutex_lock(&(pidInfo->pmutex->mutex));

		for(int i=0;i<SIZE_MAX_LOG;i++){
			pidInfo->logData[i]=arrayDATA[i];
		}
		pthread_mutex_unlock(&(pidInfo->pmutex->mutex));

		/**************************END LOG***************************/

        
        /***********SLEEP PID FREQUENCY****************/

        clock_gettime(CLOCK_MONOTONIC, &t1);//TODO
        long timeBetween=t1.tv_nsec - t0.tv_nsec;
        time_t timeSec= t1.tv_sec - t0.tv_sec;
        if(timeSec>0){
        	timeSec *=SEC_TO_NSEC;
        	timeBetween+=timeSec;
        }

		tim.tv_sec = 0;
		tim.tv_nsec = local_period - timeBetween ;
		if(timeBetween<0){

		}
		else if(timeBetween>=local_period){
			sprintf(arrayLog,"THREAD PID : TIME : %ld\n",local_period-timeBetween);
			logString(arrayLog);
		}else{

			clockNanoSleepSecure(tim.tv_nsec);
		}
		/***********END SLEEP PID FREQUENCY***********/

    }


endPid:

    set_Motor_Stop(controle_vol->motorsAll);
    logString("THREAD PID : END");
    return NULL;
}
