raphaelauv/quadcopter-raspberry-pi/src/RTIMULibDrive.cpp

////////////////////////////////////////////////////////////////////////////
//
//  This file is part of RTIMULib
//
//  Copyright (c) 2014-2015, richards-tech, LLC
//
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

#include "RTIMULib/RTIMULib.h"

int main()
{
    int sampleCount = 0;
    int sampleRate = 0;
    uint64_t rateTimer;
    uint64_t displayTimer;
    uint64_t now;

    //  Using RTIMULib here allows it to use the .ini file generated by RTIMULibDemo.
    //  Or, you can create the .ini in some other directory by using:
    //      RTIMUSettings *settings = new RTIMUSettings("<directory path>", "RTIMULib");
    //  where <directory path> is the path to where the .ini file is to be loaded/saved

    RTIMUSettings *settings = new RTIMUSettings("RTIMULib");

    printf("Avant appel\n");

    RTIMU *imu = RTIMU::createIMU(settings);

    printf("%s",imu->IMUName());

    if ((imu == NULL) || (imu->IMUType() == RTIMU_TYPE_NULL)) {
        printf("No IMU found\n");
        exit(1);
    }

    printf("ICI\n");

    //  This is an opportunity to manually override any settings before the call IMUInit

    //  set up IMU

    imu->IMUInit();

    printf("apres IMUInit\n");

    //  this is a convenient place to change fusion parameters

    imu->setSlerpPower(0.02);
    imu->setGyroEnable(true);
    imu->setAccelEnable(true);
    imu->setCompassEnable(true);

    //  set up for rate timer

    rateTimer = displayTimer = RTMath::currentUSecsSinceEpoch();

    //  now just process data

    while (1) {
        //  poll at the rate recommended by the IMU

        usleep(imu->IMUGetPollInterval() * 1000);

        while (imu->IMURead()) {
            RTIMU_DATA imuData = imu->getIMUData();
            sampleCount++;

            now = RTMath::currentUSecsSinceEpoch();

            //  display 10 times per second

            if ((now - displayTimer) > 100000) {
                printf("Sample rate %d: %s\r", sampleRate, RTMath::displayDegrees("", imuData.fusionPose));
                fflush(stdout);
                displayTimer = now;
            }

            //  update rate every second

            if ((now - rateTimer) > 1000000) {
                sampleRate = sampleCount;
                sampleCount = 0;
                rateTimer = now;
            }
        }
    }
}
