raphaelauv/quadcopter-raspberry-pi/src/serv.c

#include "serv.h"

void set_Serv_Stop(args_SERVER * argServ){
	pthread_mutex_lock(&argServ->pmutexServ->mutex);
	argServ->servStop=1;
	pthread_mutex_unlock(&argServ->pmutexServ->mutex);
}
int is_Serv_Stop(args_SERVER * argServ){

	//first look to glabal signal value
	int value=*(argServ->signalServStop);
	if(value){
		set_Serv_Stop(argServ);
		return value;

	//or look to the atomic value
	}else{
		pthread_mutex_lock(&argServ->pmutexServ->mutex);
		value=argServ->servStop;
		pthread_mutex_unlock(&argServ->pmutexServ->mutex);
		return value;
	}
}

int init_args_SERVER(args_SERVER ** argServ,volatile sig_atomic_t * signalServStop){

	PMutex * PmutexPID_INFO = NULL;
	PMutex * PmutexDataControler = NULL;
	PMutex * PmutexRemoteConnect = NULL;
	PMutex * PmutexServ = NULL;

	PID_INFO * pidInfo = NULL;
	DataController * dataControl = NULL;

	struct sockaddr_in adr_svr;
	memset(&adr_svr, 0, sizeof(adr_svr));
	adr_svr.sin_family 		= AF_INET;
	adr_svr.sin_addr.s_addr = htonl(INADDR_ANY);
	adr_svr.sin_port 		= htons(UDP_PORT_DRONE);



	*argServ = (args_SERVER *) malloc(sizeof(args_SERVER));
	if (*argServ == NULL) {
		logString("MALLOC FAIL : argServ");
		goto cleanFail;
	}


	if (((*argServ)->sock = socket(PF_INET, SOCK_DGRAM, 0)) == -1) {
		logString("SOCKET FAIL : open Socket error");
		goto cleanFail;
	}


	if(bindUDPSock(&((*argServ)->sock),&adr_svr) == -1){
		goto cleanFail;
	}



	/****************************PID_INFO**********************************/

	pidInfo = (PID_INFO *) malloc(sizeof(PID_INFO));
	if (pidInfo == NULL) {
		logString("MALLOC FAIL : pidInfo");
		goto cleanFail;
	}
	(*argServ)->pidInfo=pidInfo;

	(*argServ)->pidInfo->connectionLost = 0;

	PmutexPID_INFO = (PMutex *) malloc(sizeof(PMutex));
	if (PmutexPID_INFO == NULL) {
		logString("MALLOC FAIL : PmutexPID_INFO");
		goto cleanFail;
	}
	init_PMutex(PmutexPID_INFO);
	pidInfo->pmutex=PmutexPID_INFO;

	/**********************************************************************/


	/**************************DATA CONTROLLER*****************************/

	dataControl = (DataController *) malloc(sizeof(DataController));
	if (dataControl == NULL) {
		logString("MALLOC FAIL : dataControl");
		goto cleanFail;
	}
	(*argServ)->dataController = dataControl;


	PmutexDataControler = (PMutex *) malloc(sizeof(PMutex));
	if (PmutexDataControler == NULL) {
		logString("MALLOC FAIL : PmutexDataControler");
		goto cleanFail;
	}
	dataControl->pmutex=PmutexDataControler;
	init_PMutex(PmutexDataControler);
	dataControl->flag=2;

	/**********************************************************************/



	PmutexRemoteConnect = (PMutex *) malloc(sizeof(PMutex));
	if (PmutexRemoteConnect == NULL) {
		logString("MALLOC FAIL : PmutexRemoteConnect");
		goto cleanFail;
	}
	(*argServ)->pmutexRemoteConnect = PmutexRemoteConnect;
	init_PMutex(PmutexRemoteConnect);

	(*argServ)->signalServStop=signalServStop;
	(*argServ)->servStop=0;


	PmutexServ = (PMutex *) malloc(sizeof(PMutex));
	if (PmutexServ == NULL) {
		logString("MALLOC FAIL : mutexServ");
		goto cleanFail;
	}
	(*argServ)->pmutexServ=PmutexServ;
	init_PMutex(PmutexServ);


	return 0;

cleanFail:
	clean_args_SERVER(*argServ);
	*argServ=NULL;
	return -1;

}


void clean_args_SERVER(args_SERVER * arg) {
	if (arg != NULL) {
		clean_PMutex(arg->pmutexRemoteConnect);
		clean_PMutex(arg->pmutexServ);
		clean_DataController(arg->dataController);
		clean_PID_INFO(arg->pidInfo);
		free(arg);
	}
}

void MessageToStruc(char * message,int sizeFloat,DataController * dataTmp){

	//TODO write a real and good code for this
	int tmp=SIZE_MSG_HEADER_DATA;

	float a=strtof(message+tmp,NULL);

	tmp+=sizeFloat-1;

	float b=strtof(message+tmp-1,NULL);

	tmp+=sizeFloat-1;

	float c=strtof(message+tmp-1,NULL);

	tmp+=sizeFloat-1;

	float d=strtof(message+tmp-1,NULL);

	tmp+=sizeFloat-1;

	float flagTMP=strtof(message+tmp-1,NULL);

	char flag = (char ) flagTMP;

	dataTmp->axe_Rotation=a;
	dataTmp->axe_UpDown=b;
	dataTmp->axe_LeftRight=c;
	dataTmp->axe_FrontBack=d;
	dataTmp->flag=flag;

}


void unlockWaitMain(args_SERVER *argSERV) {
	pthread_mutex_lock(&argSERV->pmutexRemoteConnect->mutex);
	pthread_cond_signal(&argSERV->pmutexRemoteConnect->condition);
	pthread_mutex_unlock(&argSERV->pmutexRemoteConnect->mutex);
}


int firstMessage=1;
struct sockaddr_in adr_send;
int runServ = 1;
int socketConnectionMade=0;

/**
 * Manage the new Message receve by the drone
 *
 * return the flag value inside the message or -1 in case of wrong message
 */
int manageNewMessage(args_SERVER *argSERV,int sock,char * buff,int * cmpNumberMessage,DataController * dataTmp){

	if (receveNetwork(sock, NULL, buff)) {
		//TODO prendre decision sur controleur de vol , demander atterissage
		logString("THREAD SERV : RECEVE NETWORK ERROR");
		return 0;
	}


	buff[SIZE_SOCKET_MESSAGE-1] = '\0';

	char array[SIZE_MAX_LOG];
	sprintf(array, "THREAD SERV : msg receve : %s", buff);
	//logString(array);

	(*cmpNumberMessage)++;

	if(isMessageStop(buff)){

	}
	else if(isMessageRemote(buff)){

		sprintf(array, "THREAD SERV : mesg receve : %s", buff);
		logString(array);
		memset(&adr_send, 0, sizeof(adr_send));
		adr_send.sin_family = AF_INET;

		if (get_IP_Port(buff, &adr_send) != 1) {
			logString("ERROR IP RECEVE");
		} else {
			logString("THREAD SERV : GOOD IP AND PORT RECEVE");
			socketConnectionMade = 1;
			if (firstMessage) {
				unlockWaitMain(argSERV);
				firstMessage = 0;
			}
			return 2;
		}



	}else if(isMessagePause(buff)){

	}else if(isMessageStop(buff)){

	}else if(isMessageData(buff)){
		MessageToStruc(buff, 10, dataTmp);

		if(dataTmp->flag==1){
			logString("THREAD SERV : PAUSE MESSAGE");
			return 1;
		}

		else {

			/*
			if(argSERV->verbose){
				printf ("THREAD SERV : float a = %.6f  |float b = %.6f  |float c = %.6f  |float d = %.6f  | FLAG = %d\n",
						dataTmp->axe_Rotation ,dataTmp->axe_UpDown,dataTmp->axe_LeftRight,dataTmp->axe_FrontBack,dataTmp->flag);
			}
			*/


			pthread_mutex_lock(&argSERV->dataController->pmutex->mutex);

			argSERV->dataController->axe_Rotation=dataTmp->axe_Rotation;
			argSERV->dataController->axe_UpDown=dataTmp->axe_UpDown;
			argSERV->dataController->axe_LeftRight=dataTmp->axe_LeftRight;
			argSERV->dataController->axe_FrontBack=dataTmp->axe_FrontBack;
			argSERV->dataController->flag=dataTmp->flag;
			//argSERV->dataController->pmutex->var=1;

			//pthread_cond_signal(&(argSERV->dataController->pmutex->condition));

			pthread_mutex_unlock(&(argSERV->dataController->pmutex->mutex));

			if (dataTmp->flag == 0) {
				logString("THREAD SERV : FLAG 0 MESSAGE");
				return 0;
			}
			return 2;
		}

	}


	else{
		logString("THREAD SERV : UNKNOW MESSAGE\n");
		return -1;
	}
}

void *thread_UDP_SERVER(void *args) {

	args_SERVER *argSERV = (args_SERVER*) args;


	PID_INFO * pidInfo =argSERV->pidInfo;

	logString("THREAD SERV : SERVEUR UDP");
	int sock=argSERV->sock;

	int cmpNumberMessage = 1;
	char buff[SIZE_SOCKET_MESSAGE];

	/*********************************************************************/
	/*				SELECT ON UDP SOCKET*/
	/*********************************************************************/

	DataController dataTmp;

	fcntl(sock, F_SETFL, O_NONBLOCK);
	int fd_max = sock + 1;
	struct timeval tv;
	fd_set rdfs;

	int counterMsg=0;
	int freqConfirm=(int)FREQUENCY_CONTROLLER;

	
	int nbTimeOutInARow=0;
	while(runServ){

		if(is_Serv_Stop(argSERV)){
			break;
		}

		FD_ZERO(&rdfs);
		FD_SET(sock, &rdfs);
		tv.tv_sec = UDP_TIME_SEC_TIMER;
		tv.tv_usec = UDP_TIME_USEC_TIMER;
		int ret = select(fd_max, &rdfs, NULL, NULL, &tv);
		if (ret == 0) {

			if (socketConnectionMade) {

				if(nbTimeOutInARow>10){

					pthread_mutex_lock(&(pidInfo->pmutex->mutex));
					pidInfo->connectionLost = 1;
					pthread_mutex_unlock(&(pidInfo->pmutex->mutex));

					pthread_mutex_lock(&argSERV->dataController->pmutex->mutex);
					argSERV->dataController->axe_Rotation=0;
					argSERV->dataController->axe_UpDown=0;
					argSERV->dataController->axe_LeftRight=0;
					argSERV->dataController->axe_FrontBack=0;
					pthread_mutex_unlock(&(argSERV->dataController->pmutex->mutex));

					logString("THREAD SERV : Timed out");
				}else{
					nbTimeOutInARow++;
				}
			}


		} else if (FD_ISSET(sock, &rdfs)) {

			if(nbTimeOutInARow>10){
				pthread_mutex_lock(&(pidInfo->pmutex->mutex));
				pidInfo->connectionLost = 0;
				pthread_mutex_unlock(&(pidInfo->pmutex->mutex));
			}
			nbTimeOutInARow=0;
			counterMsg++;
			if(counterMsg%freqConfirm==0){

				float voltageValue;

				pthread_mutex_lock(&(pidInfo->pmutex->mutex));
				//voltageValue=pidInfo->battery;

				char arrayDATA[SIZE_MAX_LOG];
				for (int i = 0; i < SIZE_MAX_LOG; i++) {
					arrayDATA[i]=pidInfo->logData[i];
				}

				pthread_mutex_unlock(&(pidInfo->pmutex->mutex));

				char confirm[SIZE_SOCKET_MESSAGE];
				sprintf(confirm, "CONFIRM | DATA : %s", arrayDATA);

				if (sendNetwork(sock, &adr_send, confirm) == -1) {
					logString("THREAD SERV : NETWORK ERROR DURING -> SEND CONFIRM");
					//TODO
				}
			}

			if(manageNewMessage(argSERV,sock,buff,&cmpNumberMessage,&dataTmp)==0){
				//flag 0 receve
				runServ=0;
			}

		} else {
			logString("THREAD SERV : SELECT WITHOUT GOOD VALUE");
		}
	}

	/*********************************************************************/
	/*				CLOSE CONNECTION AND THREAD							 */
	/*********************************************************************/


	if (socketConnectionMade) {
		/*
		 * Code without any receve security ( and no need for )
		 * NO CRITIC SECTION
		 */
		char stop[SIZE_MSG_HEADER_STOP+1] = STR_STOP;
		logString("THREAD SERV : SEND STOP");
		for (int i = 0; i < 10; i++) {
			if (sendNetwork(sock, &adr_send, stop) == -1) {
				logString("THREAD SERV : NETWORK ERROR DURING -> SEND STOP");
				break;
			}
		}

	}

	close(sock);

	set_Serv_Stop(argSERV);
	//unlock Main
	unlockWaitMain(argSERV);

	logString("THREAD SERV : END");

	return NULL;
}
