raphaelauv/quadcopter-raspberry-pi/src/client.c

#include "client.h"


void dataControllerToMessage(int sizeFloat,char * output,DataController * dataController);
void concat(const char *typeMsg,const char *s1, const char *s2, char * messageWithInfo);


int init_args_CLIENT(args_CLIENT ** argClient,char * adresse,args_CONTROLLER * argController,volatile sig_atomic_t * signalClientStop){

	struct sockaddr_in * adr_client = NULL;
	PMutex * mutex = NULL;
	int sock=-1;

	* argClient =(args_CLIENT *) malloc(sizeof(args_CLIENT));
	if (*argClient == NULL) {
		logString("MALLOC FAIL : argClient");
		return -1;
	}

	(*argClient)->adresse=adresse;//TODO do a copy
	(*argClient)->argController=argController;
	(*argClient)->signalClientStop=signalClientStop;
	(*argClient)->clientStop=0;


	mutex =	(PMutex *) malloc(sizeof(PMutex));
	if (mutex == NULL) {
		logString("MALLOC FAIL : init_args_CLIENT mutex");
		goto cleanFail;
	}
	(*argClient)->pmutexClient=mutex;
	init_PMutex(mutex);


	if ((sock = socket(PF_INET, SOCK_DGRAM, 0)) == -1) {
		logString("args_CLIENT CLIENT : Socket error");
		goto cleanFail;
	}
	(*argClient)->sock=sock;

	//adr_my is for reception from drone
	struct sockaddr_in adr_my;
	memset(&adr_my, 0, sizeof(adr_my));
	adr_my.sin_family 		= AF_INET;
	adr_my.sin_addr.s_addr 	= htonl(INADDR_ANY);
	adr_my.sin_port 		= htons(UDP_PORT_REMOTE);


	if(bindUDPSock(&sock,&adr_my)==-1){
		logString("SOCKET ERROR : Socket BIND error");
		goto cleanFail;
	}


	if(fcntl(sock, F_SETFL, O_NONBLOCK) < 0) {
		logString("THREAD CLIENT : Socket NONBLOCK error");
		goto cleanFail;
	}


	adr_client=(struct sockaddr_in *) calloc(1,sizeof(struct sockaddr_in));
	//memset(adr_client, 0, sizeof(struct sockaddr_in));
	if (adr_client == NULL) {
		logString("MALLOC FAIL : argClient->adr_client");
		goto cleanFail;
	}


	adr_client->sin_family	= AF_INET;
	adr_client->sin_port	= htons(UDP_PORT_DRONE);

	(*argClient)->adr_client=adr_client;

	if(inet_aton(adresse, &adr_client->sin_addr)==0){
		//printf("ERROR IP ADRESSE INVALIDE FORMAT : %s\n",adresse);
		logString("FAIL INET_ATON IP ADRESS");
		goto cleanFail;
	}


	return 0;


cleanFail:
	if(sock!=-1){
		close(sock);
	}
	clean_args_CLIENT(*argClient);
	*argClient=NULL;
	return -1;

}

void clean_args_CLIENT(args_CLIENT * arg) {
	if (arg != NULL) {
		clean_PMutex(arg->pmutexClient);
		free(arg->adr_client);
		free(arg);
	}
}


void set_Client_Stop(args_CLIENT * argClient){
	pthread_mutex_lock(&argClient->pmutexClient->mutex);
	argClient->clientStop=1;
	pthread_mutex_unlock(&argClient->pmutexClient->mutex);
}
int is_Client_Stop(args_CLIENT * argClient){
	//first look to glabal signal value
	int value=*(argClient->signalClientStop);
	if(value){
		set_Client_Stop(argClient);
		return value;

	//or look to the atomic value
	}else{
		pthread_mutex_lock(&argClient->pmutexClient->mutex);
		value=argClient->clientStop;
		pthread_mutex_unlock(&argClient->pmutexClient->mutex);
		return value;
	}
}

void dataControllerToMessage(int sizeFloat,char * output,DataController * dataController){

	snprintf(output,SIZE_MSG_HEADER_DATA,"%s",STR_DATA);

	int tmp=SIZE_MSG_HEADER_DATA+1;

	output[tmp-2]=' ';

	snprintf(output+tmp-1, sizeFloat, "%f", dataController->axe_Rotation);

	tmp+=sizeFloat-1;

	output[tmp-2]=' ';

	snprintf(output+tmp-1, sizeFloat, "%f", dataController->axe_UpDown);

	tmp+=sizeFloat-1;

	output[tmp-2]=' ';

	snprintf(output+tmp-1, sizeFloat, "%f", dataController->axe_LeftRight);

	tmp+=sizeFloat-1;

	output[tmp-2]=' ';

	snprintf(output+tmp-1, sizeFloat, "%f", dataController->axe_FrontBack);

	tmp+=sizeFloat-1;

	output[tmp-2]=' ';

	snprintf(output+tmp-1, sizeFloat, "%d", dataController->flag);

	//printf("LE MESSAGE CREER EST : %s\n", output);

	//return output;
}


void concat(const char *typeMsg,const char *s1, const char *s2, char * messageWithInfo){

    char space[2];
    space[0]=' ';
    space[1]=0;

    strcpy(messageWithInfo, typeMsg);
    strcat(messageWithInfo, s1);
    strcat(messageWithInfo,(const char *) &space);
    strcat(messageWithInfo, s2);

    //return result;
}

void cleanMessageReceve(char * message,int size){

	for(int i=0;i<size;i++){
		message[i]=0;
	}
}

/**
 *
 * testCloseDrone wait for STOP confirmation from DRONE else resend a STOP MESSAGE
 *
 * if succes return 0 else return -1
 */
int testCloseDrone(int sock,struct sockaddr_in * adr_client , char * message) {
	int stopNotReceve = 1;
	int cmp=0;
	logString("THREAD CLIENT : STOP MESSAGE SENDING");
	while (stopNotReceve) {
		char messageReceve[SIZE_SOCKET_MESSAGE];
		recvfrom(sock, messageReceve, SIZE_SOCKET_MESSAGE, 0, NULL, NULL); //NON BLOCKING
		cmp++;
		if (isMessageStop(messageReceve)) {
			return 0;
		}
		else {
			if (sendNetwork(sock, adr_client, message) == -1  || cmp==10) {
				stopNotReceve = 0;
				return -1;
			}
			usleep(1000000);//TODO
		}
	}
	return 0;
}


void *thread_UDP_CLIENT(void *args) {

	args_CLIENT * argClient = (args_CLIENT *) args;
	//args_CONTROLLER * argController = argClient->argController;
	DataController * dataControl =argClient->argController->dataControl;

	int runClient = 1;

	logString("THREAD CLIENT : START");

	int sock=argClient->sock;

	struct sockaddr_in * adr_client=argClient->adr_client;

	char strPort[15];
	sprintf(strPort, "%d", UDP_PORT_REMOTE);

	char myIP[64];
	char messageWithInfo[SIZE_SOCKET_MESSAGE];


	if(getIP(myIP)){
		logString("THREAD CLIENT : IP error");
		//TODO
		runClient=0;
	}
	if(myIP!=NULL){//TODO
		concat(STR_REMOTE,myIP,strPort,messageWithInfo);
		messageWithInfo[SIZE_SOCKET_MESSAGE-1]='\0';

		if(sendNetwork(sock,adr_client,messageWithInfo)==-1){
			logString("THREAD CLIENT : SEND NETWORK error");
			runClient=0;
			//TODO
		}

		//sendto(sock, messageWithInfo,SIZE_SOCKET_MESSAGE, 0, (struct sockaddr *) &adr_svr,sizeof(struct sockaddr_in));
		char array[SIZE_MAX_LOG];
		sprintf(array,"THREAD CLIENT SENDED : %s", messageWithInfo);
		logString(array);

	}else{
		//TODO
		logString("THREAD CLIENT : getIP null");
		runClient=0;
		//TODO
	}


	const int sizeFLOAT=10;
	//int sizeMessage=5*sizeFLOAT;
	char message[SIZE_SOCKET_MESSAGE];
	int resultWait;

	int flag;
	char messageReceve[SIZE_SOCKET_MESSAGE];
	//int resultMessageReceve=0;

	//int TMPvalueClientStop=0;
	while (runClient) {


		struct timespec timeToWait;
		struct timeval now;

		int timeInMs=1;

		if(gettimeofday(&now, NULL)){
			logString("THREAD CLIENT : gettimeofday Fail");
			runClient=0;
		}

		timeToWait.tv_sec = now.tv_sec + 1;
		timeToWait.tv_nsec = (now.tv_usec + 1000UL * timeInMs) * 1000UL;//TODO le temps mettre dans des macros


		pthread_mutex_lock(&dataControl->pmutex->mutex);


		resultWait=pthread_cond_timedwait(&dataControl->pmutex->condition,
					&dataControl->pmutex->mutex,&timeToWait);

		if(resultWait==ETIMEDOUT){
			logString("THREAD CLIENT : TIMER LIMIT");
		}


		if(is_Client_Stop(argClient)){
			dataControl->flag=0;
		}

		dataControllerToMessage(sizeFLOAT,message ,dataControl);
		flag=dataControl->flag;
		pthread_mutex_unlock(&dataControl->pmutex->mutex);



		message[SIZE_SOCKET_MESSAGE-1]='\0';
		char array[SIZE_MAX_LOG];
		sprintf(array,"THREAD CLIENT : SENDING : %s", message);
		logString(array);

		if(sendNetwork(sock,adr_client,message)==-1){
			logString("THREAD CLIENT : sendNetwork Fail");
			runClient=0;
		}
		//ARRET
		if (flag == 0) {

			if (testCloseDrone(sock, adr_client, message)) {
				logString("THREAD CLIENT : ERROR message STOP from DRONE NOT RECEVE");
			} else {
				logString("THREAD CLIENT : STOP MSG RECEVE FROM DRONE");
			}
			runClient = 0;
			continue;
		}

		if (recvfrom(sock, messageReceve, SIZE_SOCKET_MESSAGE, 0, NULL, NULL)> 0) {//NON BLOCKING

			if (isMessageStop(messageReceve)) {
				logString("THREAD CLIENT : STOP MSG RECEVE FROM DRONE");
				runClient = 0;
				continue;
			}

			char array[SIZE_MAX_LOG];
			sprintf(array,"THREAD CLIENT : RECEVE : %s", messageReceve);
			logString(array);
			cleanMessageReceve(messageReceve,SIZE_SOCKET_MESSAGE);
		}


	}

	close(sock);
	set_Client_Stop(argClient);
	logString("THREAD CLIENT : END");
	return NULL;
}
