raphaelauv/quadcopter-raspberry-pi/src/network.c

#include "network.h"

/**
 * Fill sa ( sockaddr_in ) with the ip and number port inside the message
 *
 * return 0 if FAIL ,else 1
 */
char get_IP_Port(char *message,struct sockaddr_in * sa){

	if(isMessageRemote(message)){
		message+=SIZE_MSG_HEADER_REMOTE;
	}else{
		return 0;
	}

	char ip[50];
	int cmp=0;
	while(*message!=' '){
		ip[cmp]=*message;
		message++;
		cmp++;
	}

	message++;
	int cmp2=0;

	char port[5];

	while(*message!='\0' && *message!=' ' && cmp2<5){
		port[cmp2]=*message;
		message++;
		cmp2++;
	}
	port[4]='\0';

	int nbPort = atoi(port);
	if(nbPort>0 && nbPort<9999){
		sa->sin_port=htons(nbPort);
	}else{
		return 0;
	}
	
	ip[cmp]='\0';

	//printf("ip get : %s\n",ip);
	return inet_pton(AF_INET,(const char *) &ip, &(sa->sin_addr));
}

char isMessage(char * messageReceve, char * messageToTest,int nb) {
	char str1[SIZE_SOCKET_MESSAGE];
	char str2[SIZE_SOCKET_MESSAGE];
	int res = 0;

	strcpy(str1, messageToTest);
	strcpy(str2, messageReceve);

	if(nb>0){
		res = strncmp(str1, str2, nb);
	}else{
		res = strcmp(str1, str2);
	}
	return res == 0;
}

char isMessageRemote(char * message){
	char msg[SIZE_MSG_HEADER_REMOTE+1] = STR_REMOTE;
	return isMessage(message,msg,SIZE_MSG_HEADER_REMOTE);
}
char isMessageData(char * message){
	char msg[SIZE_MSG_HEADER_DATA+1] = STR_DATA;
	return isMessage(message,msg,SIZE_MSG_HEADER_DATA);
}

char isMessagePause(char * message) {
	char msg[SIZE_MSG_HEADER_PAUSE+1] = STR_PAUSE;
	return isMessage(message,msg,0);
}

char isMessageStop(char * message){
	char msg[SIZE_MSG_HEADER_STOP+1] = STR_STOP;
	return isMessage(message,msg,0);
}


/**
 * Bind the sock with adr_svr information and set it SO_REUSEADDR
 *
 * return -1 if FAIL , else 0
 */
int bindUDPSock(int * sock, struct sockaddr_in * adr_svr) {

	int enable = 0;

	if (setsockopt(*sock, SOL_SOCKET, SO_REUSEADDR, &enable, sizeof(int)) < 0) {
		logString("bindUDPSock : setsockopt(SO_REUSEADDR) failed");
		return -1;
	}

	if (bind(*sock, (struct sockaddr *) adr_svr, sizeof(*adr_svr))) {
		logString("bindUDPSock : bind error");
		return -1;
	}
	return 0;
}


/**
 * Fill message with the receved message , message size should be at least SIZE_SOCKET_MESSAGE
 * Fill adr_svr with the receved Info
 *
 * Return 1 in case of Error else 0
 */
int receveNetwork(int sock, struct sockaddr_in *adr_svr, char * message) {
	int sizeReveceTotal = 0;
	int resultReceve=0;
	int nbfail = 0;

	while (sizeReveceTotal < SIZE_SOCKET_MESSAGE && nbfail < 10) {
		resultReceve = recvfrom(sock, &message[sizeReveceTotal],
				SIZE_SOCKET_MESSAGE - sizeReveceTotal, 0, NULL, NULL);

		if (resultReceve < 1) {
			nbfail++;
		} else {
			sizeReveceTotal += resultReceve;
		}
	}
	if (nbfail == 10) {
		return 1;
	} else {
		return 0;
	}

}

/**
 * Send message to adr_svr , message size should be at least SIZE_SOCKET_MESSAGE
 *
 * Return -1 in case of Error else 0
 */
int sendNetwork(int sock,struct sockaddr_in *adr_svr,char * message) {
	int sended=0;
	int resultSend=0;
	int nbfail=0;
	while (sended < SIZE_SOCKET_MESSAGE && nbfail<10) {
		resultSend = sendto(sock, &message[sended],
			SIZE_SOCKET_MESSAGE - sended, 0, (struct sockaddr *) adr_svr,
				sizeof(struct sockaddr_in));


		if (resultSend == -1) {
			nbfail++;
		}else{
			sended += resultSend;
		}
	}
	if(nbfail==10){
		return -1;
	}else{
		return 0;
	}
}

/**
 * Fill myIP with an IP availalble on the network interface
 * myIP need to be malloc of a size of 64 char
 *
 * return -1 if FAIL , else return 0 in SUCCES
 */
int getIP(char*  myIP) {
	if(myIP==NULL){
		return -1;
	}
	char str1[64];
	char str2[64];
	char str3[64];

	strcpy(str1, "127.0.0.1");

	int notfind=1;

	struct ifaddrs *myaddrs, *addrsTMP;
	struct sockaddr_in *s4;
	int status;
	/*
	char *ip = (char *) malloc(64 * sizeof(char));
	if(ip==NULL){
		return;
	}
	*/
	status = getifaddrs(&myaddrs);
	if (status != 0) {
		logString("Probleme de recuperation d'adresse IP");
		return -1;
	}
	for (addrsTMP = myaddrs; addrsTMP != NULL; addrsTMP = addrsTMP->ifa_next) {
		if (addrsTMP->ifa_addr == NULL) {
			continue;
		}

		if ((addrsTMP->ifa_flags & IFF_UP) == 0) {
			continue;
		}

		if (addrsTMP->ifa_addr->sa_family == AF_INET) {
			s4 = (struct sockaddr_in *) (addrsTMP->ifa_addr);
			if (inet_ntop(addrsTMP->ifa_addr->sa_family,
					(void *) &(s4->sin_addr), myIP, 64 * sizeof(char)) != NULL) {

				int ret = 0;

				
				strcpy(str2, myIP);

				ret = strcmp(str1, str2);

				if (ret != 0) {
					notfind=0;
					strcpy(str3, myIP);
					char array[SIZE_MAX_LOG];
					sprintf(array,"Adresse IP :%s", str3);
					logString(array);
				}
				//strcpy(myIP,ip);
			}
		}
	}
	freeifaddrs(myaddrs);
	//free(ip);
	//return nameIp;

	if(notfind){
		strcpy(myIP,str1);	
		char array[SIZE_MAX_LOG];
		sprintf(array,"Adresse IP :%s", myIP);
		logString(array);
		return 0;
	}


	strcpy(myIP,str3);
	return 0;
}

void readIpAdresse(char * ipAdresse,int size){
	system(SOUND_COMMAND"My_Ip_Adresse_Is.mp3");usleep(SOUND_PAUSE_TIME);
	for(int i=0;i<size;i++){
		if(ipAdresse[i]=='\0'){
			break;
		}
		switch (ipAdresse[i]){
			case '.': system(SOUND_COMMAND"point.mp3");usleep(SOUND_PAUSE_TIME);break;
			case '0': system(SOUND_COMMAND"0.mp3");usleep(SOUND_PAUSE_TIME);break;
			case '1': system(SOUND_COMMAND"1.mp3");usleep(SOUND_PAUSE_TIME);break;
			case '2': system(SOUND_COMMAND"2.mp3");usleep(SOUND_PAUSE_TIME);break;
			case '3': system(SOUND_COMMAND"3.mp3");usleep(SOUND_PAUSE_TIME);break;
			case '4': system(SOUND_COMMAND"4.mp3");usleep(SOUND_PAUSE_TIME);break;
			case '5': system(SOUND_COMMAND"5.mp3");usleep(SOUND_PAUSE_TIME);break;
			case '6': system(SOUND_COMMAND"6.mp3");usleep(SOUND_PAUSE_TIME);break;
			case '7': system(SOUND_COMMAND"7.mp3");usleep(SOUND_PAUSE_TIME);break;
			case '8': system(SOUND_COMMAND"8.mp3");usleep(SOUND_PAUSE_TIME);break;
			case '9': system(SOUND_COMMAND"9.mp3");usleep(SOUND_PAUSE_TIME);break;
		}
	}
}
