raphaelauv/quadcopter-raspberry-pi/src/PWM/I2C_custom.c

/*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
 * Name        		: I2C_custom.c
 * Author      		: raphaelauv
 * Original Author  : Georgi Todorov <terahz@geodar.com>
 * Created on  		: Apr 3, 2017
 *
 * Copyright © 2017 Raphaelauv
 */

#include <sys/ioctl.h>
#include <errno.h>
#include <stdio.h>      /* Standard I/O functions */
#include <fcntl.h>
#include <unistd.h>
#include <linux/i2c.h>
#include <linux/i2c-dev.h>
#include <syslog.h>		/* Syslog functionality */
#include "I2C_custom.h"

int initI2C_custom(I2C_custom ** i2c_cus,int bus, int address){

	*i2c_cus = (I2C_custom *) malloc(sizeof(I2C_custom));
	if (*i2c_cus == NULL) {
		logString("MALLOC FAIL : I2C_custom");
		return -1;
	}

	(*i2c_cus)->_i2cbus = bus;
	(*i2c_cus)->_i2caddr = address;

	snprintf((*i2c_cus)->busfile, sizeof((*i2c_cus)->busfile), "/dev/i2c-%d", bus);
	if(I2C_custom_openfd(*i2c_cus)){
		logString("I2C_custom FAIL : I2C_custom_openfd");
		return -1;
	}
	return 0;
}

void cleanI2C_custom(I2C_custom * i2c_cus) {
	if(i2c_cus!=NULL){
		if(i2c_cus->fd!=-1){
			//close(i2c_cus->fd);
		}
		free(i2c_cus);
	}
}
//! Read a single byte from I2C Bus
/*!
 \param address register address to read from
 */
uint8_t I2C_custom_read_byte(I2C_custom * i2c_cus,uint8_t address) {
	if (i2c_cus->fd != -1) {
		uint8_t buff[BUFFER_SIZE];
		buff[0] = address;
		if (write(i2c_cus->fd, buff, BUFFER_SIZE) != BUFFER_SIZE) {
			/*
			char strArray[SIZE_MAX_LOG];
			sprintf(strArray, "I2C_CUSTOM FAIL : Failed to write to I2C slave 0x%x register 0x%x [read_byte():write %d]",
					i2c_cus->_i2caddr, address, errno);
			logString(array);
			*/
			return (-1);
		} else {
			if (read(i2c_cus->fd, i2c_cus->dataBuffer, BUFFER_SIZE) != BUFFER_SIZE) {
				/*
				char strArray[SIZE_MAX_LOG];
				sprintf(strArray, "I2C_CUSTOM FAIL : Failed to read from I2C slave 0x%x, register 0x%x [read_byte():read %d]",
						i2c_cus->_i2caddr, address, errno);
				logString(array);
				*/
				return (-1);
			} else {
				return i2c_cus->dataBuffer[0];
			}
		}
	} else {
		//logString("I2C_CUSTOM Device File not available. Aborting read");
		return (-1);
	}

}


uint8_t I2C_custom_write_multiple_byte(I2C_custom * i2c_cus,uint8_t * address, uint8_t * data,uint8_t number) {

	uint8_t buff[2*number];
	for(int i=0;i<number;i++){
		buff[i*2] = address[i];
		buff[((i*2)+1)] = data[i];
		i++;
	}
	if (i2c_cus->fd != -1) {

		if (write(i2c_cus->fd, buff, sizeof(buff)) != 2*number) {

			/*
			char strArray[SIZE_MAX_LOG];
			sprintf(strArray, "I2C_CUSTOM FAIL : Failed to write to I2C Slave 0x%x @ register 0x%x [write_byte():write %d]",
					i2c_cus->_i2caddr, address, errno);
			logString(array);
			*/
			return (-1);
		} else {
			/*
			char strArray[SIZE_MAX_LOG];
			sprintf(strArray, "I2C_CUSTOM SUCCES : Wrote to I2C Slave 0x%x @ register 0x%x [0x%x]",
					i2c_cus->_i2caddr, address, data);
			logString(array);
			*/
			return 0;
		}
	} else {
		logString("I2C_CUSTOM Device File not available. Aborting write");
		return (-1);
	}


}




//! Write a single byte from a I2C Device
/*!
 \param address register address to write to
 \param data 8 bit data to write
 */
uint8_t I2C_custom_write_byte(I2C_custom * i2c_cus,uint8_t address, uint8_t data) {
	if (i2c_cus->fd != -1) {
		uint8_t buff[2];
		buff[0] = address;
		buff[1] = data;
		if (write(i2c_cus->fd, buff, sizeof(buff)) != 2) {

			/*
			char strArray[SIZE_MAX_LOG];
			sprintf(strArray, "I2C_CUSTOM FAIL : Failed to write to I2C Slave 0x%x @ register 0x%x [write_byte():write %d]",
					i2c_cus->_i2caddr, address, errno);
			logString(array);
			*/
			return (-1);
		} else {
			/*
			char strArray[SIZE_MAX_LOG];
			sprintf(strArray, "I2C_CUSTOM SUCCES : Wrote to I2C Slave 0x%x @ register 0x%x [0x%x]",
					i2c_cus->_i2caddr, address, data);
			logString(array);
			*/
			return 0;
		}
	} else {
		logString("I2C_CUSTOM Device File not available. Aborting write");
		return (-1);
	}
	
}
//! Open device file for I2C Device
int I2C_custom_openfd(I2C_custom * i2c_cus) {
	if ((i2c_cus->fd = open(i2c_cus->busfile, O_RDWR)) < 0) {

		/*
		char strArray[SIZE_MAX_LOG];
		sprintf(strArray, "I2C_CUSTOM FAIL : Couldn't open I2C Bus %d [openfd():open %d]", i2c_cus->_i2cbus,errno);
		logString(array);
		*/
		return -1;
	}
	if (ioctl(i2c_cus->fd, I2C_SLAVE, i2c_cus->_i2caddr) < 0) {
		/*
		char strArray[SIZE_MAX_LOG];
		sprintf(strArray, "I2C_CUSTOM FAIL : I2C slave %d failed [openfd():ioctl %d]", i2c_cus->_i2caddr,errno);
		logString(array);
		*/

		return -1;
	}
	return 0;
}
