raphaelauv/quadcopter-raspberry-pi/src/client.h

#ifndef CLIENT_H_
#define CLIENT_H

#include "concurrent.h"
#include "network.h"
#include "Controller/controller.h"

typedef struct args_CLIENT {
	int sock;
	char * adresse;
	int clientStop;
	PMutex * pmutexClient;
	volatile sig_atomic_t * signalClientStop;
	struct sockaddr_in * adr_client;
	args_CONTROLLER * argController;
} args_CLIENT;


int init_args_CLIENT(args_CLIENT ** argClient,char * adresse,args_CONTROLLER * argController,volatile sig_atomic_t * signalClientStop);
void clean_args_CLIENT(args_CLIENT * arg);

void set_Client_Stop(args_CLIENT * argClient);
int is_Client_Stop(args_CLIENT * argClient);

void *thread_UDP_CLIENT(void *args);

#endif /* CLIENT_H_ */
