raphaelauv/quadcopter-raspberry-pi/(commit log)

2015-10-07 Comprendre les composants
2015-10-12 Description des composant
2015-10-12 liste des liens visité lors des recherches
2015-10-14 liste (final ?) des composant avec une idée de prix
2015-10-23 source pdf
    [Devis.ods]
2015-10-23 schema du cablage et Jounal pour savoir se qu on va faire par la suite
2015-10-30 maj des liens
2015-11-20 Programation parallele et gestion des interuptions
2015-11-20 Jai enlever les exexecutables
2015-11-20 Ajout des liens pour les composants manquant dans le journal
2016-01-29 lecture du gyro, non fonctionnel
2016-10-05 Nettoyage du git , ajout tableau contenant protocols de securite
    [protocol securite.ods]
2016-10-06 Correction repertoire Git
    [protocol securite.ods]
2016-10-07 Library Adafruit_10DOF pour arduino
2016-10-07 Ajout library Arduino pour CAPTEUR
2016-10-15 Ajout de la lib pour les capteur pour RASPBERRY
2016-12-01 Correction choix Ip pour remote client
    [client.c]
2016-12-02 Correction threadServerTcp
2016-12-04 Correction timer pour le select du serv
    [remote.c, serv.c]
2016-12-04 Correction sur le select TERMINER !! la telecommande est FIN PRETE
    [remote.c, serv.c]
2016-12-05 Ajout code pour controlé motors.
2016-12-16 Gestion concurrence entre threads
2016-12-16 ajoute la possibilité d'arreté les moteurs.
2016-12-17 Debut code Controleur de Vol ( pour petit tests)
2016-12-17 amelioration interface moteurs et premier essai avec un controleur de vol qui recopie juste les valeur demandé par la telecomande.
2016-12-18 Correction concurrence entre PID et MOTORS et SERV sur drone et ajout debut MakeFile
    [concurrent.c, controldeVol.c, controldeVol.h, droneMain.c, motors.c, motors.h, serv.c, serv.h]
2017-01-16 Correction concurrence entre Controleur de Vol et Motors
    [client.c, controldeVol.c, droneMain.c, motors.c, motors.h]
2017-01-17 Petit resumé a propo des regulateur PID
2017-01-17 Nettoyage general du code , ajout fonctions de FREE
2017-01-19 Petite Correction du code Client et des Threads du Drone
    [client.c, client.h, motors.c, serv.c]
2017-01-19 Correction cast malloc , ajout script compilation et makefile presque fini
    [client.c, controldeVol.c, droneMain.c, motors.c, motors.h]
2017-01-19 Ajout code Free args threads chez client
2017-01-22 Refactoring fichiers , petites corrections
    [client.c, client.h, clientRemoteMain.c, controldeVol.c, droneMain.c, serv.c]
2017-01-23 Debut du protocol d'arret , correction du mode VERBOSE
    [controldeVol.c, motors.c, motors.h, serv.c]
2017-01-23 Securisation des Malloc du code DRONE
2017-01-23 Correction gestion message dans SERV.c
    [network.h, serv.c]
2017-01-25 valeur des axes en pourcentage (de -100 a 100 en float) plus ajout du controller playstation
2017-01-25 suppression d un printf
2017-01-25 plus de segmentation fault quand il n y a pas de controller brancher
2017-01-25 ajout d un printf en mode verbose si pas de manette
2017-01-27 Ajout dossier Calibrage: ce code calibre les ESCs. Ce programme fonctionne comme un Controleur_vol.
2017-01-27 Deplacement LIB en dehors de SRC , deplacement code entre client.c et RemoteMain.c
2017-01-27 Petit Automatisation code Calibration
2017-01-27 Ajout de code pour calibrer ESC avec un arduino UNO et Pouvoir teste le controle des moteur avec l'arduino.
2017-01-27 Ajout de Dans calibrage d'un test pour voir si on a un bon calibrage des ESCs.
2017-01-27 Ajout fichier tableur avec les poids des composants du drone
    [Poids.ods]
2017-01-28 ajout de specification de la manette
2017-01-28 Correction liberation memoire , code d'appel au capteur
    [Calibration_ESC.c, concurrent.c, concurrent.h, controldeVol.cpp, droneMain.c, motors.c, motors.h]
2017-01-28 Imprementation d'un controleur de vol, il ne prend pas compte des donne envoi par le client.
2017-01-29 Correction CLIENT/ Manette sur frequence
    [client.c, motors.c]
2017-01-29 Correction Code Reseaux securisation des envoi et reception
    [client.c, network.c, network.h, serv.c]
2017-01-29 Correction Serv.c avec Network.c
    [serv.c]
2017-01-29 Ajout d'un document exel pour mieux comprendre comment fonctionne le PID.
    [PID_Comportement.xlsx]
2017-01-29 Changement des noms des graphique.
    [PID_Comportement.xlsx]
2017-01-30 Correction General , ajout commentaire , sucurisation valeur pour moteur
    [controldeVol.cpp, droneMain.c, motors.c, motors.h, serv.c]
2017-01-30 Correction liberation Memoire Client , Fermeture Thread Manette quand Client ferme
    [client.c, clientRemoteMain.c, serv.c]
2017-01-30 Securisation thread des moteurs , affichage valeur Capteur
2017-01-31 Correction Reseaux -> Fermeture Urgence , ajout commentaire et refactoring code
    [client.c, clientRemoteMain.c, motors.c, network.c, network.h, serv.c]
2017-01-31 Ajout Entete dans les messages du PROTOCOL
2017-02-01 Factorisation code , ajout securité threads motors
2017-02-09 Correction , REFACTORING code , ajout securité reseau
    [client.c, clientRemoteMain.c, concurrent.c, concurrent.h, controldeVol.cpp, droneMain.c, motors.c, motors.h]
2017-02-11 Refactoring , pour code generique en nombre de moteurs 70% done
2017-02-11 Refactoring , Code Generique MOTORS DONE
2017-02-13 Debut LOG
    [Poids.ods]
2017-02-16 Ajout mode --noControl pour automatiser test PID
2017-02-17 Ajout barrier pour Thread Motors
2017-02-17 Finalisation Barrier , factorisation join des motors
2017-02-17 Correction makeFile pour Log
    [client.c, droneMain.c]
2017-02-20 Debut implementation Mono-Threading pour les moteurs
2017-02-20 Implementation Mono-Threading 70%
2017-02-20 Premier teste d'un PID avec 2 moteur(Moteur n°0 et 1)
2017-02-20 Correction erreur dans Test_PID.h
    [Test_PID.h]
2017-02-20 Nettoyage de la Documentation
    [PID_Comportement.xlsx, Poids.ods, protocol securite.ods]
2017-02-21 Mono thread MOTEUR 95%
2017-02-22 Mono-thread 99% , MakeFile avec ARM detection pour Raspberry PI
2017-02-22 Ajout des config a faire avec le raspberry dans le README.md
2017-02-22 Ajout du fichier de config du capteur.
2017-02-22 Correction Bug lecture Ip
    [clientRemoteMain.c, concurrent.c, concurrent.h, droneMain.c, network.c, network.h, serv.c]
2017-02-22 Correction fermeture Serv par le SigKill
    [PID.cpp, motors.c, serv.c]
2017-02-22 Ajout Define Pour Motor et PID
2017-02-22 Ajout d'un fichier TODO.txt . Mettre son nom quand on s'occupe de quelque chose SVP.
2017-02-22 Debug Du usleep du Pid Negatif
2017-02-23 Mono Thread MOTORS 100% -> TIME_LATENCY ajouté
2017-02-23 renomage variable + fonction du gestionnaire de signal
2017-02-23 Ajout securité Client et reorganisation code Motor.c
2017-02-24 Log PID Frequence 100%
2017-02-24 Calibration Test
2017-02-24 Changement du PID.
2017-03-01 Ajout Fermeture MOTEUR pendant SECURITY sleep du PID
2017-03-03 Changement de l'input du PID.
2017-03-03 Changement des Parametre du PID.
2017-03-03 Debug PID.cpp
2017-03-07 Ajout de la fonction d'analyse TOken pour les options d'entree (90%)
2017-03-10 Optimisation Calibration et Token
2017-03-15 optimsiation Log , correction interface MotorInit , Modif AlgoMotor
    [PID.cpp, droneMain.c, log.c, log.h, motors.c, motors.h]
2017-03-15 Pid , test puissance Manette
2017-03-15 Debug Log angle in PID
2017-03-15 Desactivation valeur Manette dans PID
2017-03-15 Ajout Macro pour PID
2017-03-16 Ajout Macro Log , correction drone Print IP
    [PID.cpp, client.c, clientRemoteMain.c, droneMain.c, log.c, log.h, motors.c]
2017-03-17 test Drone PID , valeur Angle sans Macro
2017-03-20 Correction general , amelioration TOken et Log et Pid
    [PID.cpp, PID.hpp, clientRemoteMain.c, concurrent.h, droneMain.c, log.c, log.h]
2017-03-20 Petit Update du Code de Motor.c
2017-03-22 Correction gestion Signaux et fermeture Quand manette absente
    [PID.cpp, clientRemoteMain.c, droneMain.c, serv.c]
2017-03-22 DEBUG -> val Max motor.c
2017-03-23 Update Calibration , Ajout Macro TOKEN , Update COmmunication Drone vers Client
2017-03-27 Correction Select Serv , Correction Branchement et Debranchement remote
    [client.c, concurrent.h, serv.c]
2017-03-27 Correction Controller , ajout reprise de control du Drone
2017-03-30 Reecriture Lib C de MCP3008 en C
2017-04-05 code pour testé L'ADC.
2017-04-05 Interface code Hardware MCP and ADC
2017-04-05 Calibration Capteur.
2017-04-05 Debug ADC 2
2017-04-05 Interfacing ADC code inside PID
2017-04-05 Update name Capteru -> Sensor
2017-04-05 Traduction des librairies pour communiquer avec la carte PWM de adafruit
2017-04-05 Update Lib PWM card (debug) + testFile
2017-04-05 Securisation Lib PWM
2017-04-06 Update lib Motor.c et interfacage avec le programme
2017-04-06 Log valeur Battery
2017-04-06 Correction Fermeture des mortor avec lib Motor3
    [motors.c]
2017-04-06 Debug Minimum PWM LED value
2017-04-06 Test Multiple I2C write
2017-04-06 Macro CHANNEL I2C
2017-04-06 Debug Minimum PWM LED value
    Test Multiple I2C write
    Correction Name
    Macro CHANNEL I2C
    Debug Frequency PCA
    Debug ...
    Debug freq PCA
    [I2C_custom.c, I2C_custom.h, PCA9685.c, PCA9685.h, PID.cpp, motors.c]
2017-04-07 Correction ADC et PWM et test avec wiringPiI2C
    [MCP3008.c, MCP3008.h, PCA9685.c, PCA9685.h, PID.cpp, client.c, client.h, clientRemoteMain.c]
2017-04-07 Finalisation SIGNAUX et fermeture propres des threads CLIENT ET DRONE
2017-04-10 Debug Correction Calibration
2017-04-21 PID pour le roll et le yaw ajouté au pid general.
2017-04-21 PID with clock_nanosleep
2017-04-21 Debug val PID YAW
2017-04-26 Correction API motorAll
2017-04-26 Correction Pitch avec manette
    [PID.cpp, PID.hpp]
2017-04-27 Correction noC , et Log
    [PID.cpp, clientRemoteMain.c, droneMain.c, log.c, log.h]
2017-04-28 Ajout valeur Puissance Motoeur , Correction PLOT et valeur PID battery
    [Evolution Puissance Moteurs.ods]
2017-04-28 Correction Pid
2017-04-28 Debug Battery Power
2017-04-28 Ajout fichier Mesures Decharge Battery
    [Decharge Battery.ods]
2017-04-28 Update tableau Puissance Decharge
    [Decharge Battery.ods, Evolution Puissance Moteurs.ods]
2017-05-02 Calcul Correction Puissance / Battery
    [Decharge Battery.ods, Evolution Puissance Moteurs.ods]
2017-05-02 Calcul Correction theorique
    [Decharge Battery.ods, Evolution Puissance Moteurs.ods]
2017-05-02 Implementation Correction Battery
    [Decharge Battery.ods]
2017-05-02 Ajout experience Avec calibration Puissance / Battery
    [Decharge Battery.ods]
2017-05-02 Ajout printf Val PowerAsk
2017-05-04 Correction LogFile emplacement et ajout readme pour lancement script
    [clientRemoteMain.c, log.c, log.h]
2017-05-04 Edit script and Value PID
2017-05-04 Edit freq Battery , Makefile separation suppresion DATA file et Reglage PID
2017-05-05 Factorisation ,ajout Arg pour testervibration et Struct entre PID et serv pour communiquer valeurs au client ( exemple Battery value )
2017-05-05 Ajout testADC , ajout transfer Value Battery -> client
2017-05-05 Edit Precision Accelerometre CAPTEUR
2017-05-06 Refactoring , Ajout vibration
    [Vibration.ods]
2017-05-06 Correction Vibration du Pitch
    [PID.cpp, PID.hpp, RTIMULib.ini, calibrate.c]
2017-05-06 Update Documentation
    [Decharge Battery.ods, Evolution Puissance Moteurs.ods, Vibration.ods]
2017-05-07 Correction sur les Plot
    [PID.cpp]
2017-05-07 Correction Log et refactoring
    [PID.cpp, serv.c]
2017-05-07 Correction NameFile log et data
    [PID.cpp, PID.hpp, concurrent.h, log.c, log.h]
2017-05-09 Test Val Gyro
2017-05-09 Test sans Angle , que Gyro
2017-05-09 DEBUG PID CRUCIAL !!!
2017-05-09 Ajout petit Rotation Security Timer
2017-05-09 Desactivation Calibrage Battery
2017-05-10 Add file Config.txt
    [config.txt]
2017-05-18 Refactoring complet des controller avec SDL
2017-05-26 Ajout securite sur PID en cas de perte de reseaux
2017-05-26 Fermeture GAZ et PID apres Longue deconnection
2017-05-26 Debug Fermeture Drone apres TImerOUT
2017-05-29 Ajout LOG de Vol
